tiydwe/SRAM/README.md

# SRAM from scratch
256 bytes of SRAM from discrete sot-23 mosfets built without any ICs!

I'm still working on this project!

More coming to this README eventually.
