tiydwe/SRAM/BOM.xlsx

Item | Qty | Cost (total) | Description | URL
OSEN 2300 | 3000 | $16.80 | n-mosfets | https://www.lcsc.com/product-detail/C20607736.html
OSEN 2301 | 3000 | $21.00 | p-mosfets | https://www.lcsc.com/product-detail/C20607737.html
Lian Xin Technology XDFH-0259-2*20P | 25 | $15.32 | idc headers, right angle | https://www.lcsc.com/product-detail/C19193829.html
Lian Xin Technology XDFH-0254-2*20P | 20 | $8.72 | idc headers | https://www.lcsc.com/product-detail/C19193815.html
YFW MUR1560FAC | 15 | $6.35 | diodes for charge pump | https://www.lcsc.com/product-detail/C3039987.html
luJing 1N4148 | 50 | $0.43 | diodes for rising edge detector | https://www.lcsc.com/product-detail/C49318123.html
YAGEO CC0805KRX7R9BB104 | 600 | $7.68 | general decoupling caps 0805 (100n) | https://www.lcsc.com/product-detail/C49678.html
YAGEO CC0603KRX7R0BB104 | 500 | $4.40 | general decoupling caps 0603 (100n) | https://www.lcsc.com/product-detail/C113803.html
HRE CGA0805X5R475K500MT | 20 | $0.78 | more capacitors (4.7u) | https://www.lcsc.com/product-detail/C6119903.html
HRE CGA1206X5R476M250NT | 10 | $2.88 | more capacitors (47u) | https://www.lcsc.com/product-detail/C6119973.html
ChuangHui RV102M250G120R1Z00ZZ | 10 | $2.53 | capacitors for charge pump (1m, low esr) | https://www.lcsc.com/product-detail/C49435126.html
FH RS-06000JT | 100 | $0.35 | resistors (0) | https://www.lcsc.com/product-detail/C115323.html
FOJAN FRC0805F1R00TS | 100 | $0.42 | resistors (1) | https://www.lcsc.com/product-detail/C2907233.html
FOJAN FRC0805F4R70TS | 100 | $0.41 | resistors (4.7) | https://www.lcsc.com/product-detail/C2933459.html
FOJAN FRC0805F10R0TS | 100 | $0.32 | resistors (10) | https://www.lcsc.com/product-detail/C2907220.html
FOJAN FRC0805F47R0TS | 100 | $0.32 | resistors (47) | https://www.lcsc.com/product-detail/C2907268.html
FOJAN FRC0805F4700TS | 100 | $0.32 | resistors (470) | https://www.lcsc.com/product-detail/C2907267.html
FOJAN FRC0805F4701TS | 100 | $0.30 | resistors (4.7k) | https://www.lcsc.com/product-detail/C2907264.html
FOJAN FRC0805F1002TS | 100 | $0.27 | resistors (10k) | https://www.lcsc.com/product-detail/C2907219.html
FOJAN FRC0805F4702TS | 100 | $0.32 | resistors (47k) | https://www.lcsc.com/product-detail/C2930202.html
FOJAN FRC0805F1003TS | 100 | $0.33 | resistors (100k) | https://www.lcsc.com/product-detail/C2907217.html
PCB (ram controller board) | 1 | $50.00 | approx value, not quoted yet | N/A
PCB (main demux board) | 1 | $48.37 | 150mmx150mm, 4 layer, tg155, lead free hasl | N/A
PCBA (main boards) | 17 | $380.00 | including the 20 thousand mosfets | N/A
KNSCHA 126RV0112 | 100 | $4.40 | some more capacitors (100u) | https://www.lcsc.com/product-detail/C7461243.html
Yongyu PhotXINGLIGHT XL-2012SURC-FJoelectric SZYY0805R | 500 | $8.80 | red leds | https://www.lcsc.com/product-detail/C7371909.html
FOJAN FRC0805F1800TS | 500 | $1.15 | resistors (180) for led circuit | https://www.lcsc.com/product-detail/C2933344.html
hanxia HX PZ1.0-1x2P ZZ | 150 | $4.86 | pin headers, small | https://www.lcsc.com/product-detail/C22438170.html
RS-03K47R0FT | 2186 | $0.00 | included in pcb price, 47 ohm resistors | https://www.lcsc.com/product-detail/C140087.html
FOJAN FRC0603F1002TS | 282 | $0.00 | included in pcb price, 10k ohm resistors | https://www.lcsc.com/product-detail/C2906982.html
SHOU HAN TS4538TP 250gf 009 | 150 | $2.61 | push buttons | https://www.lcsc.com/product-detail/C5359325.html
PCB (input board) | 1 | $15.00 | pcb | N/A
JLCPCB shipping + tarrifs | N/A | $100.00 | approx, based on past experience and extrapolating | N/A
LCSC shipping + tarriffs | N/A | $50.00 | approx, based on past experience and extrapolating | N/A
GRAND TOTAL |  | $755.44
