tiydwe/SRAM/kicad/inputBoard/production/bom.csv

Designator | Footprint | Quantity | Value | LCSC Part #
J1_4, J1_3, J1_2, J1, J2_4, J2_3, J2_2, J2, J3_4, J3_3, J3_2, J3, J4_4, J4_3, J4_2, J4, J5_4, J5_3, J5_2, J5, J6_4, J6_3, J6_2, J6, J7_4, J7_3, J7_2, J7, J8_4, J8_3, J8_2, J8 | PinHeader_1x02_P1.00mm_Vertical | 32 | Conn_01x02_Pin
R1_4, R1_3, R1_2, R1, R2_4, R2_3, R2_2, R2, R3_4, R3_3, R3_2, R3, R4_4, R4_3, R4_2, R4, R5_4, R5_3, R5_2, R5 | 1206 | 20 | 0R
SW1_4, SW1_3, SW1_2, SW1, SW10_4, SW10_3, SW10_2, SW10, SW11_4, SW11_3, SW11_2, SW11, SW12_4, SW12_3, SW12_2, SW12, SW13_4, SW13_3, SW13_2, SW13, SW14_4, SW14_3, SW14_2, SW14, SW15_4, SW15_3, SW15_2, SW15, SW16_4, SW16_3, SW16_2, SW16, SW2_4, SW2_3, SW2_2, SW2, SW3_4, SW3_3, SW3_2, SW3, SW4_4, SW4_3, SW4_2, SW4, SW5_4, SW5_3, SW5_2, SW5, SW6_4, SW6_3, SW6_2, SW6, SW7_4, SW7_3, SW7_2, SW7, SW8_4, SW8_3, SW8_2, SW8, SW9_4, SW9_3, SW9_2, SW9 | SW_4.5mm | 64 | SW_Push
