tiydwe/SRAM/kicad/smt_to_dip/production/bom.csv

Designator | Footprint | Quantity | Value | LCSC Part #
J1_91, J1_90, J1_89, J1_88, J1_87, J1_86, J1_85, J1_84, J1_83, J1_82, J1_81, J1_80, J1_79, J1_78, J1_77, J1_76, J1_75, J1_74, J1_73, J1_72, J1_71, J1_70, J1_69, J1_68, J1_67, J1_66, J1_65, J1_64, J1_63, J1_62, J1_61, J1_60, J1_59, J1_58, J1_57, J1_56, J1_55, J1_54, J1_53, J1_52, J1_51, J1_50, J1_49, J1_48, J1_47, J1_46, J1_45, J1_44, J1_43, J1_42, J1_41, J1_40, J1_39, J1_38, J1_37, J1_36, J1_35, J1_34, J1_33, J1_32, J1_31, J1_30, J1_29, J1_28, J1_27, J1_26, J1_25, J1_24, J1_23, J1_22, J1_21, J1_20, J1_19, J1_18, J1_17, J1_16, J1_15, J1_14, J1_13, J1_12, J1_11, J1_10, J1_9, J1_8, J1_7, J1_6, J1_5, J1_4, J1_3, J1_2, J1 | PinHeader_1x03_P2.54mm_Vertical | 91 | Conn_01x03_Pin
Q1_91, Q1_90, Q1_89, Q1_88, Q1_87, Q1_86, Q1_85, Q1_84, Q1_83, Q1_82, Q1_81, Q1_80, Q1_79, Q1_78, Q1_77, Q1_76, Q1_75, Q1_74, Q1_73, Q1_72, Q1_71, Q1_70, Q1_69, Q1_68, Q1_67, Q1_66, Q1_65, Q1_64, Q1_63, Q1_62, Q1_61, Q1_60, Q1_59, Q1_58, Q1_57, Q1_56, Q1_55, Q1_54, Q1_53, Q1_52, Q1_51, Q1_50, Q1_49, Q1_48, Q1_47, Q1_46, Q1_45, Q1_44, Q1_43, Q1_42, Q1_41, Q1_40, Q1_39, Q1_38, Q1_37, Q1_36, Q1_35, Q1_34, Q1_33, Q1_32, Q1_31, Q1_30, Q1_29, Q1_28, Q1_27, Q1_26, Q1_25, Q1_24, Q1_23, Q1_22, Q1_21, Q1_20, Q1_19, Q1_18, Q1_17, Q1_16, Q1_15, Q1_14, Q1_13, Q1_12, Q1_11, Q1_10, Q1_9, Q1_8, Q1_7, Q1_6, Q1_5, Q1_4, Q1_3, Q1_2, Q1 | SOT-23 | 91 | Q_NMOS_GSD
R1_91, R1_90, R1_89, R1_88, R1_87, R1_86, R1_85, R1_84, R1_83, R1_82, R1_81, R1_80, R1_79, R1_78, R1_77, R1_76, R1_75, R1_74, R1_73, R1_72, R1_71, R1_70, R1_69, R1_68, R1_67, R1_66, R1_65, R1_64, R1_63, R1_62, R1_61, R1_60, R1_59, R1_58, R1_57, R1_56, R1_55, R1_54, R1_53, R1_52, R1_51, R1_50, R1_49, R1_48, R1_47, R1_46, R1_45, R1_44, R1_43, R1_42, R1_41, R1_40, R1_39, R1_38, R1_37, R1_36, R1_35, R1_34, R1_33, R1_32, R1_31, R1_30, R1_29, R1_28, R1_27, R1_26, R1_25, R1_24, R1_23, R1_22, R1_21, R1_20, R1_19, R1_18, R1_17, R1_16, R1_15, R1_14, R1_13, R1_12, R1_11, R1_10, R1_9, R1_8, R1_7, R1_6, R1_5, R1_4, R1_3, R1_2, R1 | 0603 | 91 | R
R2_91, R2_90, R2_89, R2_88, R2_87, R2_86, R2_85, R2_84, R2_83, R2_82, R2_81, R2_80, R2_79, R2_78, R2_77, R2_76, R2_75, R2_74, R2_73, R2_72, R2_71, R2_70, R2_69, R2_68, R2_67, R2_66, R2_65, R2_64, R2_63, R2_62, R2_61, R2_60, R2_59, R2_58, R2_57, R2_56, R2_55, R2_54, R2_53, R2_52, R2_51, R2_50, R2_49, R2_48, R2_47, R2_46, R2_45, R2_44, R2_43, R2_42, R2_41, R2_40, R2_39, R2_38, R2_37, R2_36, R2_35, R2_34, R2_33, R2_32, R2_31, R2_30, R2_29, R2_28, R2_27, R2_26, R2_25, R2_24, R2_23, R2_22, R2_21, R2_20, R2_19, R2_18, R2_17, R2_16, R2_15, R2_14, R2_13, R2_12, R2_11, R2_10, R2_9, R2_8, R2_7, R2_6, R2_5, R2_4, R2_3, R2_2, R2 | 0805 | 91 | R
R3_91, R3_90, R3_89, R3_88, R3_87, R3_86, R3_85, R3_84, R3_83, R3_82, R3_81, R3_80, R3_79, R3_78, R3_77, R3_76, R3_75, R3_74, R3_73, R3_72, R3_71, R3_70, R3_69, R3_68, R3_67, R3_66, R3_65, R3_64, R3_63, R3_62, R3_61, R3_60, R3_59, R3_58, R3_57, R3_56, R3_55, R3_54, R3_53, R3_52, R3_51, R3_50, R3_49, R3_48, R3_47, R3_46, R3_45, R3_44, R3_43, R3_42, R3_41, R3_40, R3_39, R3_38, R3_37, R3_36, R3_35, R3_34, R3_33, R3_32, R3_31, R3_30, R3_29, R3_28, R3_27, R3_26, R3_25, R3_24, R3_23, R3_22, R3_21, R3_20, R3_19, R3_18, R3_17, R3_16, R3_15, R3_14, R3_13, R3_12, R3_11, R3_10, R3_9, R3_8, R3_7, R3_6, R3_5, R3_4, R3_3, R3_2, R3 | 1206 | 91 | R
