tiydwe/SRAM/kicad/mainDemuxBoard/production/bom.csv

Designator | Footprint | Quantity | Value | LCSC Part #
J1, J10, J11, J12, J13, J14, J15, J16, J17, J2, J3, J4, J5, J6, J7, J8, J9 | IDC-Header_2x20_P2.54mm_Latch_Vertical | 17 | Conn_02x20_Top_Bottom
Q1, Q10, Q100, Q101, Q102, Q103, Q109, Q11, Q110, Q111, Q112, Q113, Q119, Q12, Q120, Q121, Q122, Q123, Q129, Q13, Q130, Q131, Q132, Q133, Q139, Q140, Q141, Q142, Q143, Q149, Q150, Q151, Q152, Q153, Q159, Q160, Q161, Q162, Q163, Q19, Q20, Q21, Q22, Q23, Q29, Q3, Q30, Q31, Q32, Q33, Q39, Q40, Q41, Q42, Q43, Q49, Q5, Q50, Q51, Q52, Q53, Q59, Q60, Q61, Q62, Q63, Q69, Q7, Q70, Q71, Q72, Q73, Q79, Q80, Q81, Q82, Q83, Q89, Q9, Q90, Q91, Q92, Q93, Q99 | SOT-23-P | 84 | PMOS | C41384537
Q104, Q105, Q106, Q107, Q108, Q114, Q115, Q116, Q117, Q118, Q124, Q125, Q126, Q127, Q128, Q134, Q135, Q136, Q137, Q138, Q14, Q144, Q145, Q146, Q147, Q148, Q15, Q154, Q155, Q156, Q157, Q158, Q16, Q164, Q165, Q166, Q167, Q168, Q169, Q17, Q170, Q171, Q172, Q173, Q174, Q175, Q176, Q177, Q178, Q179, Q18, Q180, Q181, Q182, Q183, Q184, Q2, Q24, Q25, Q26, Q27, Q28, Q34, Q35, Q36, Q37, Q38, Q4, Q44, Q45, Q46, Q47, Q48, Q54, Q55, Q56, Q57, Q58, Q6, Q64, Q65, Q66, Q67, Q68, Q74, Q75, Q76, Q77, Q78, Q8, Q84, Q85, Q86, Q87, Q88, Q94, Q95, Q96, Q97, Q98 | SOT-23-N | 100 | NMOS | C49308282
R1, R10, R11, R12, R13, R14, R15, R16, R2, R3, R4, R5, R6, R7, R8, R9 | 0603 | 16 | 10kR | C54920960
