tiydwe/SRAM/kicad/sramBoard/sramBoard.csv

Reference | Qty | Value | DNP | Exclude from BOM | Exclude from Board | Exclude from Simulation | Exclude from Position Files | Footprint | Datasheet
Q1,Q2,Q4,Q6,Q7,Q8,Q9,Q10,Q12,Q14,Q15,Q16,Q17,Q18,Q20,Q22,Q23,Q24,Q25,Q26,Q28,Q30,Q31,Q32,Q33,Q34,Q36,Q38,Q39,Q40,Q41,Q42,Q44,Q46,Q47,Q48,Q49,Q50,Q52,Q54,Q55,Q56,Q57,Q58,Q60,Q62,Q63,Q64,Q65,Q66,Q68,Q70,Q71,Q72,Q73,Q74,Q76,Q78,Q79,Q80,Q81,Q82,Q84,Q86,Q87,Q88,Q89,Q90,Q92,Q94,Q95,Q96,Q97,Q98,Q100,Q102,Q103,Q104,Q105,Q106,Q108,Q110,Q111,Q112,Q113,Q114,Q116,Q118,Q119,Q120,Q121,Q122,Q124,Q126,Q127,Q128,Q129,Q130,Q132,Q134,Q135,Q136,Q137,Q138,Q140,Q142,Q143,Q144,Q145,Q146,Q148,Q150,Q151,Q152,Q153,Q154,Q156,Q158,Q159,Q160,Q161,Q162,Q164,Q166,Q167,Q168,Q169,Q170,Q172,Q174,Q175,Q176,Q177,Q178,Q180,Q182,Q183,Q184,Q185,Q186,Q188,Q190,Q191,Q192,Q193,Q194,Q196,Q198,Q199,Q200,Q201,Q202,Q204,Q206,Q207,Q208,Q209,Q210,Q212,Q214,Q215,Q216,Q217,Q218,Q220,Q222,Q223,Q224,Q225,Q226,Q228,Q230,Q231,Q232,Q233,Q234,Q236,Q238,Q239,Q240,Q241,Q242,Q244,Q246,Q247,Q248,Q249,Q250,Q252,Q254,Q255,Q256,Q257,Q258,Q260,Q262,Q263,Q264,Q265,Q266,Q268,Q270,Q271,Q272,Q273,Q274,Q276,Q278,Q279,Q280,Q281,Q282,Q284,Q286,Q287,Q288,Q289,Q290,Q292,Q294,Q295,Q296,Q297,Q298,Q300,Q302,Q303,Q304,Q305,Q306,Q308,Q310,Q311,Q312,Q313,Q314,Q316,Q318,Q319,Q320,Q321,Q322,Q324,Q326,Q327,Q328,Q329,Q330,Q332,Q334,Q335,Q336,Q337,Q338,Q340,Q342,Q343,Q344,Q345,Q346,Q348,Q350,Q351,Q352,Q353,Q354,Q356,Q358,Q359,Q360,Q361,Q362,Q364,Q366,Q367,Q368,Q369,Q370,Q372,Q374,Q375,Q376,Q377,Q378,Q380,Q382,Q383,Q384,Q385,Q386,Q388,Q390,Q391,Q392,Q393,Q394,Q396,Q398,Q399,Q400,Q401,Q402,Q404,Q406,Q407,Q408,Q409,Q410,Q412,Q414,Q415,Q416,Q417,Q418,Q420,Q422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 | 868 | NMOS |  |  |  |  | ${EXCLUDE_FROM_POS_FILES} | easyeda2kicad:SOT-23-N | https://ngspice.sourceforge.io/docs/ngspice-html-manual/manual.xhtml#cha_MOSFETs
Q3,Q5,Q11,Q13,Q19,Q21,Q27,Q29,Q35,Q37,Q43,Q45,Q51,Q53,Q59,Q61,Q67,Q69,Q75,Q77,Q83,Q85,Q91,Q93,Q99,Q101,Q107,Q109,Q115,Q117,Q123,Q125,Q131,Q133,Q139,Q141,Q147,Q149,Q155,Q157,Q163,Q165,Q171,Q173,Q179,Q181,Q187,Q189,Q195,Q197,Q203,Q205,Q211,Q213,Q219,Q221,Q227,Q229,Q235,Q237,Q243,Q245,Q251,Q253,Q259,Q261,Q267,Q269,Q275,Q277,Q283,Q285,Q291,Q293,Q299,Q301,Q307,Q309,Q315,Q317,Q323,Q325,Q331,Q333,Q339,Q341,Q347,Q349,Q355,Q357,Q363,Q365,Q371,Q373,Q379,Q381,Q387,Q389,Q395,Q397,Q403,Q405,Q411,Q413,Q419,Q421,Q427,Q429,Q435,Q437,Q443,Q445,Q451,Q453,Q459,Q461,Q467,Q469,Q475,Q477,Q483,Q485,Q491,Q493,Q499,Q501,Q507,Q509,Q515,Q517,Q523,Q525,Q531,Q533,Q539,Q541,Q547,Q549,Q555,Q557,Q563,Q565,Q571,Q573,Q579,Q581,Q587,Q589,Q595,Q597,Q603,Q605,Q611,Q613,Q619,Q621,Q627,Q629,Q635,Q637,Q643,Q645,Q651,Q653,Q659,Q661,Q667,Q669,Q675,Q677,Q683,Q685,Q691,Q693,Q699,Q701,Q707,Q709,Q715,Q717,Q723,Q725,Q731,Q733,Q739,Q741,Q747,Q749,Q755,Q757,Q763,Q765,Q771,Q773,Q779,Q781,Q787,Q789,Q795,Q797,Q803,Q805,Q811,Q813,Q819,Q821,Q827,Q829,Q835,Q837,Q843,Q845,Q851,Q853,Q859,Q861,Q867,Q869,Q875,Q877,Q883,Q885,Q891,Q893,Q899,Q901,Q907,Q909,Q915,Q917,Q923,Q925,Q931,Q933,Q939,Q941,Q947,Q949,Q955,Q957,Q963,Q965,Q971,Q973,Q979,Q981,Q987,Q989,Q995,Q997,Q1003,Q1005,Q1011,Q1013,Q1019,Q1021,Q1025,Q1027,Q1029,Q1031,Q1033,Q1034,Q1035,Q1036,Q1037,Q1043,Q1044,Q1045,Q1046,Q1047,Q1053,Q1054,Q1055,Q1056,Q1057,Q1063,Q1064,Q1065,Q1066,Q1067,Q1073,Q1074,Q1075,Q1076,Q1077,Q1083,Q1084,Q1085,Q1086,Q1087,Q1093,Q1094,Q1095,Q1096,Q1097,Q1103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 | 340 | PMOS |  |  |  |  | ${EXCLUDE_FROM_POS_FILES} | easyeda2kicad:SOT-23-P | https://ngspice.sourceforge.io/docs/ngspice-html-manual/manual.xhtml#cha_MOSFETs
R1,R2,R3,R4,R5,R6,R7,R8,R9,R10,R11,R12,R13,R14,R15,R16,R17,R18,R19,R20,R21,R22,R23,R24,R25,R26,R27,R28,R29,R30,R31,R32,R33,R34,R35,R36,R37,R38,R39,R40,R41,R42,R43,R44,R45,R46,R47,R48,R49,R50,R51,R52,R53,R54,R55,R56,R57,R58,R59,R60,R61,R62,R63,R64,R65,R66,R67,R68,R69,R70,R71,R72,R73,R74,R75,R76,R77,R78,R79,R80,R81,R82,R83,R84,R85,R86,R87,R88,R89,R90,R91,R92,R93,R94,R95,R96,R97,R98,R99,R100,R101,R102,R103,R104,R105,R106,R107,R108,R109,R110,R111,R112,R113,R114,R115,R116,R117,R118,R119,R120,R121,R122,R123,R124,R125,R126,R127,R128 | 128 | 47R |  |  |  |  | ${EXCLUDE_FROM_POS_FILES} | Resistor_SMD:R_0603_1608Metric
R129,R130,R131,R132,R133,R134,R135,R136,R137,R138,R139,R140,R141,R142,R143,R144 | 16 | 10kR |  |  |  |  | ${EXCLUDE_FROM_POS_FILES} | Resistor_SMD:R_0603_1608Metric
