tiydwe/SRAM/ltspice/powermanagement.asc

C3: cap; 100nC
C4: cap; 1mC
C5: cap; 1mC
C6: cap; 1mC
C7: cap; 1mC
C8: cap; 1mC
D1: diode
D2: diode
D3: diode
D4: diode
D5: diode
D6: diode
D7: diode
D8: diode
D9: diode
D10: diode
D11: diode
D12: diode
M3: pmos; DO2301E-Q
M4: nmos; JTD2302B
M5: pmos; DO2301E-Q
M6: nmos; JTD2302B
M7: pmos; DO2301E-Q
M8: nmos; JTD2302B
M10: pmos; DO2301E-Q
M11: pmos; DO2301E-Q
M12: pmos; DO2301E-Q
M13: nmos; JTD2302B
M15: nmos; JTD2302B
M17: nmos; JTD2302B
R5: res; 470R
R6: res; 10R
R9: res; 47R
R10: res; 47R
R11: res; 1R
R12: res; 47R
R13: res; 47R
R14: res; 1R
V1: voltage; 5
Named nets: 0
.model JTD2302B NMOS(Level=1 Vto=0.65 Kp=22.8 Lambda=0.01 Rs=15m Rd=20m Cgso=120p Cgdo=80p Cbd=120p Vact=20 Is=1n)
.model DO2301E-Q PMOS(Level=1 Vto=-0.6 Kp=6.75 Lambda=0.02 Rd=40m Rs=17m Rg=5 Rds=20Meg Cgso=126p Cgdo=30p Cbd=10p Pb=0.8 Mj=0.5 Is=1e-14 N=1 Rb=0.1 mfg=Doingter)
.tran 0 50m 0 startup
