tiydwe/SRAM/ltspice/mainSimulation.asc

M1: pmos; DO2301E-Q
M2: pmos; DO2301E-Q
M3: nmos; JTD2302B
M4: nmos; JTD2302B
M5: pmos; DO2301E-Q
M6: pmos; DO2301E-Q
M7: nmos; JTD2302B
M8: nmos; JTD2302B
M27: pmos; DO2301E-Q
M28: nmos; JTD2302B
V1: voltage; 5
V2: voltage; PWL(0m 0 400m 0 401m 5)
V3: voltage; PULSE(0 5 100m 1m 1m 50m 100m)
Named nets: 0
.model JTD2302B NMOS(Level=1 Vto=0.65 Kp=22.8 Lambda=0.01 Rs=15m Rd=20m Cgso=120p Cgdo=80p Cbd=120p Vact=20 Is=1n)
.model DO2301E-Q PMOS(Level=1 Vto=-0.6 Kp=6.75 Lambda=0.02 Rd=40m Rs=17m Rg=5 Rds=20Meg Cgso=126p Cgdo=30p Cbd=10p Pb=0.8 Mj=0.5 Is=1e-14 N=1 Rb=0.1 mfg=Doingter)
.tran 0 1 0 startup
.options cshunt=1e-12
