tiydwe/SRAM/ltspice/simulation.asc

C1: cap; 100pC
C3: cap; 32n
M1: nmos; JTD2302B
M2: nmos; JTD2302B
M3: nmos; JTD2302B
M4: nmos; JTD2302B
M5: nmos; JTD2302B
M6: nmos; JTD2302B
M7: pmos; DO2301E-Q
M8: pmos; DO2301E-Q
M9: nmos; JTD2302B
M10: nmos; JTD2302B
M11: nmos; JTD2302B
M12: pmos; DO2301E-Q
M13: pmos; DO2301E-Q
M14: nmos; JTD2302B
M15: pmos; DO2301E-Q
M16: pmos; DO2301E-Q
M17: nmos; JTD2302B
M18: nmos; JTD2302B
M19: nmos; JTD2302B
M20: nmos; JTD2302B
M21: nmos; JTD2302B
M22: nmos; JTD2302B
M23: nmos; JTD2302B
M24: nmos; JTD2302B
M25: nmos; JTD2302B
M26: nmos; JTD2302B
M27: nmos; JTD2302B
M28: nmos; JTD2302B
M29: nmos; JTD2302B
M30: nmos; JTD2302B
M31: nmos; JTD2302B
M32: nmos; JTD2302B
M33: nmos; JTD2302B
M34: nmos; JTD2302B
M35: nmos; JTD2302B
M36: nmos; JTD2302B
M37: pmos; DO2301E-Q
M38: pmos; DO2301E-Q
M39: nmos; JTD2302B
M40: nmos; JTD2302B
M41: pmos; DO2301E-Q
M42: nmos; JTD2302B
M43: nmos; JTD2302B
M44: pmos; DO2301E-Q
M45: nmos; JTD2302B
M46: pmos; DO2301E-Q
R1: res; 10kR
R2: res; 1R
R3: res; 47R
R4: res; 1R
R5: res; 10kR
R6: res; 10kR
R7: res; 10kR
R8: res; 10kR
V1: voltage; 5
V2: voltage; PWL(0 0 95m 0 100m 5)
V3: voltage; PWL(0 5 200m 5 205m 0)
V4: voltage; 5
V5: voltage; PWL(0 5 200m 5 205m 0 295m 0 300m 5)
V7: voltage; PWL(0 0 49m 0 50m 10 99m 10 100m 0 149m 0 150m 10 199m 10 200m 0 249m 0 250m 10 299m 10 300m 0)
Named nets: 0
.model JTD2302B NMOS(Level=1 Vto=0.65 Kp=22.8 Lambda=0.01 Rs=15m Rd=20m Cgso=120p Cgdo=80p Cbd=120p Vact=20 Is=1n)
.model DO2301E-Q PMOS(Level=1 Vto=-0.6 Kp=6.75 Lambda=0.02 Rd=40m Rs=17m Rg=5 Rds=20Meg Cgso=126p Cgdo=30p Cbd=10p Pb=0.8 Mj=0.5 Is=1e-14 N=1 Rb=0.1 mfg=Doingter)
.tran 0 1 0 startup
