tiydwe/SRAM/ltspice/schmitt_trigger.asc

C1: cap; 1pC
C2: cap; 4.7µC
C3: cap; 100nC
C5: cap; 100nC
C6: cap; 4.7µC
C7: cap; 100nC
C8: cap; 100nC
C9: cap; 100nC
C10: cap; 4.7µC
C11: cap; 1µC
D1: diode
D2: diode
D3: diode
M1: pmos; DO2301E-Q
M2: pmos; DO2301E-Q
M3: pmos; DO2301E-Q
M4: nmos; JTD2302B
M5: pmos; DO2301E-Q
M6: nmos; JTD2302B
M7: nmos; JTD2302B
M8: nmos; JTD2302B
M9: pmos; DO2301E-Q
M10: nmos; JTD2302B
M11: pmos; DO2301E-Q
M12: nmos; JTD2302B
M13: pmos; DO2301E-Q
M14: nmos; JTD2302B
M15: pmos; DO2301E-Q
M16: nmos; JTD2302B
M17: pmos; DO2301E-Q
M18: nmos; JTD2302B
M19: pmos; DO2301E-Q
M20: nmos; JTD2302B
M21: pmos; DO2301E-Q
M22: nmos; JTD2302B
M23: pmos; DO2301E-Q
M24: nmos; JTD2302B
M25: pmos; DO2301E-Q
M26: nmos; JTD2302B
M27: pmos; DO2301E-Q
M28: nmos; JTD2302B
R1: res; 47R
R2: res; 47R
R3: res; 10R
R4: res; 47R
R5: res; 47R
R6: res; 10R
R7: res; 1kR
R8: res; 10kR
R9: res; 47R
R10: res; 1R
R11: res; 100kR
R12: res; 47R
R13: res; 4.7kR
R14: res; 4.7R
R15: res; 47R
R16: res; 4.7R
R17: res; 47kR
R18: res; 47R
R19: res; 4.7R
R20: res; 4.7kR
R21: res; 47R
R22: res; 4.7R
R23: res; 47R
V1: voltage; 5
V2: voltage; PWL(0m 0 100m 5 200m 5 300m 0 400m 0 450m 5 460m 3 500m 5 600m 0 700m 0 720m 3 730m 1 750m 2 780m 0)
Named nets: 0
.model JTD2302B NMOS(Level=1 Vto=0.65 Kp=22.8 Lambda=0.01 Rs=15m Rd=20m Cgso=120p Cgdo=80p Cbd=120p Vact=20 Is=1n)
.model DO2301E-Q PMOS(Level=1 Vto=-0.6 Kp=6.75 Lambda=0.02 Rd=40m Rs=17m Rg=5 Rds=20Meg Cgso=126p Cgdo=30p Cbd=10p Pb=0.8 Mj=0.5 Is=1e-14 N=1 Rb=0.1 mfg=Doingter)
.tran 0 1 0 startup
.options cshunt=1e-12
