tiydwe/SRAM/ltspice/dlatch.asc

C1: cap; 5nC
M1: pmos; DO2301E-Q
M2: pmos; DO2301E-Q
M3: nmos; JTD2302B
M4: nmos; JTD2302B
M5: pmos; DO2301E-Q
M6: pmos; DO2301E-Q
M7: nmos; JTD2302B
M8: nmos; JTD2302B
M9: nmos; JTD2302B
M10: pmos; DO2301E-Q
M11: nmos; JTD2302B
M12: pmos; DO2301E-Q
M13: nmos; JTD2302B
M15: pmos; DO2301E-Q
V1: voltage; 5
V2: voltage; PWL(0m 0 99m 0 100m 5 139m 5 140m 0 179.9m 0 180m 5 182m 5 182.1m 0)
V3: voltage; PWL(0m 0 49m 0 50m 5 79m 5 80m 0 119m 0 120m 5 159m 5 160m 0)
Named nets: 0
.model JTD2302B NMOS(Level=1 Vto=0.65 Kp=22.8 Lambda=0.01 Rs=15m Rd=20m Cgso=120p Cgdo=80p Cbd=120p Vact=20 Is=1n)
.model DO2301E-Q PMOS(Level=1 Vto=-0.6 Kp=6.75 Lambda=0.02 Rd=40m Rs=17m Rg=5 Rds=20Meg Cgso=126p Cgdo=30p Cbd=10p Pb=0.8 Mj=0.5 Is=1e-14 N=1 Rb=0.1 mfg=Doingter)
.tran 0 1 0 startup
