tiydwe/SRAM/kicad/inputBoard/inputBoard.kicad_pcb

## KiCad design kicad/inputBoard/inputBoard.kicad_pcb (2026-10-28)

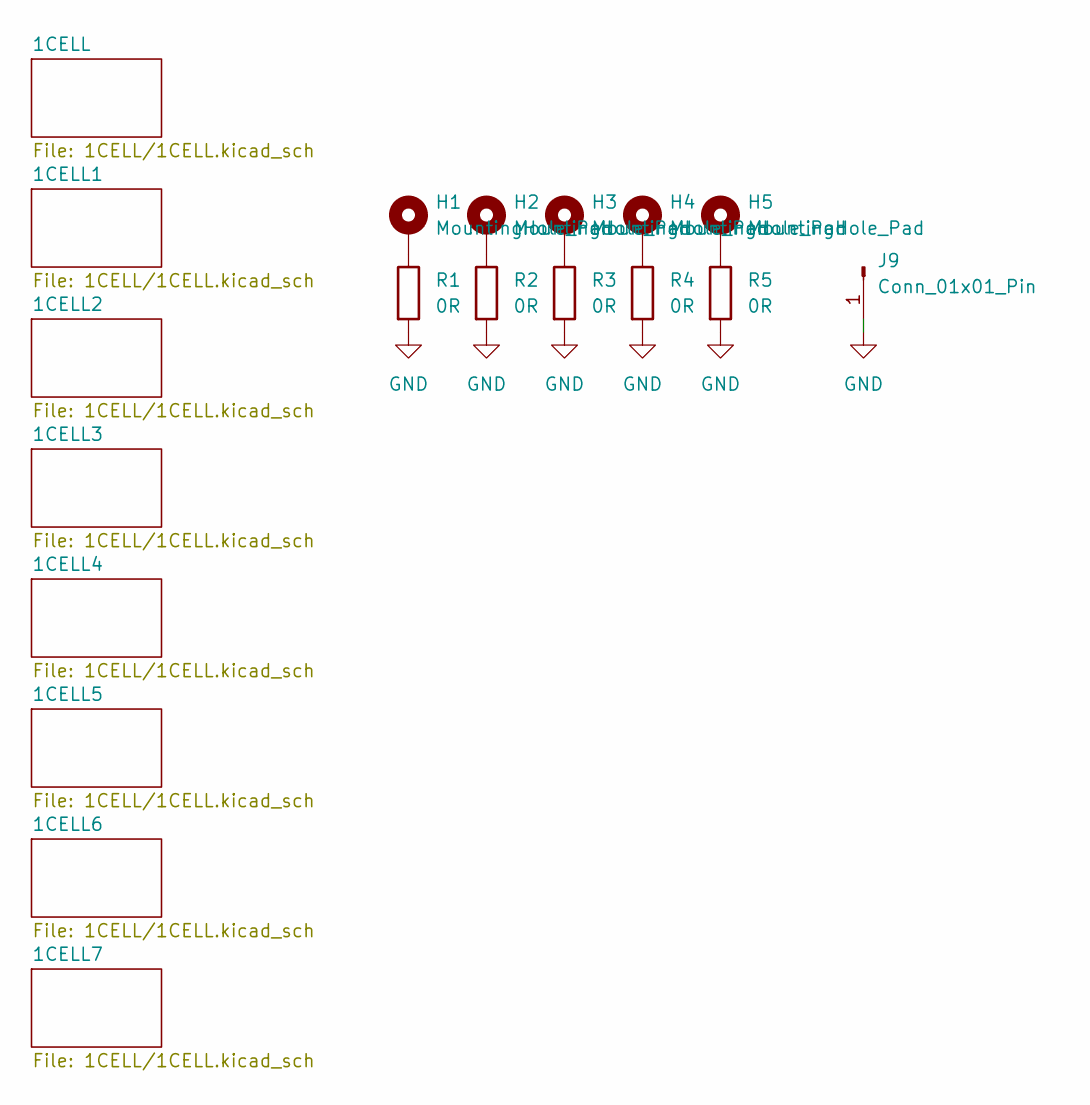
[picture p37: schematic inputBoard.kicad_sch]

Parts:
H1, H2, H3, H4, H5: MountingHole_Pad; MountingHole_2.2mm_M2_DIN965_Pad
J9: Conn_01x01_Pin; Wire_Pad_18AWG_stranded
R1, R2, R3, R4, R5: 0R; R_1206_3216Metric_Pad1.30x1.75mm_HandSolder

Connections:
GND: J9.1 (Pin_1_1), R1.2, R2.2, R3.2, R4.2, R5.2; also elsewhere on the board
unnamed: H1.1 (1_1), R1.1
unnamed: H2.1 (1_1), R2.1
unnamed: H3.1 (1_1), R3.1
unnamed: H4.1 (1_1), R4.1
unnamed: H5.1 (1_1), R5.1

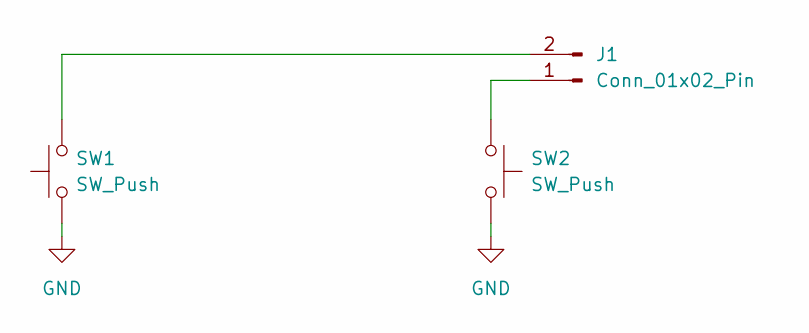
[picture p38: schematic 1CELL.kicad_sch]

Parts:
J1: Conn_01x02_Pin; PinHeader_1x02_P1.00mm_Vertical
SW1, SW2: SW_Push; SW_4.5mm

Connections:
GND: SW1.1, SW2.2; also elsewhere on the board
unnamed: J1.1, SW2.1
unnamed: J1.2, SW1.2

Parts of its further copies:
J2, J3, J4, J5, J6, J7, J8: Conn_01x02_Pin; PinHeader_1x02_P1.00mm_Vertical
SW3, SW4, SW5, SW6, SW7, SW8, SW9, SW10, SW11, SW12, SW13, SW14, SW15, SW16: SW_Push; SW_4.5mm

Connections of its further copies:
GND: SW3.1, SW4.2, SW5.1, SW6.2, SW7.1, SW8.2, SW9.1, SW10.2, SW11.1, SW12.2, SW13.1, SW14.2, SW15.1, SW16.2; also elsewhere on the board
unnamed: J2.1, SW4.1
unnamed: J2.2, SW3.2
unnamed: J3.1, SW6.1
unnamed: J3.2, SW5.2
unnamed: J4.1, SW8.1
unnamed: J4.2, SW7.2
unnamed: J5.1, SW10.1
unnamed: J5.2, SW9.2
unnamed: J6.1, SW12.1
unnamed: J6.2, SW11.2
unnamed: J7.1, SW14.1
unnamed: J7.2, SW13.2
unnamed: J8.1, SW16.1
unnamed: J8.2, SW15.2

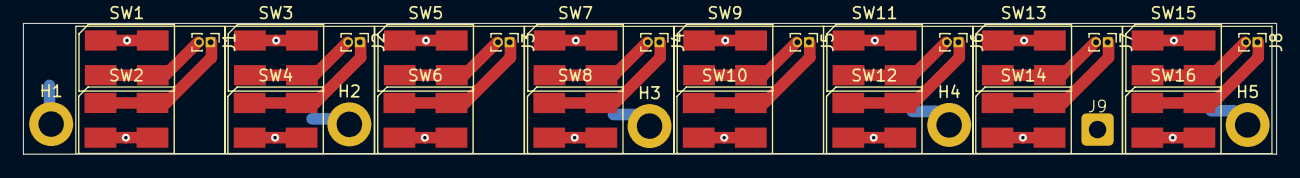
[picture p39: board inputBoard.kicad_pcb from above]

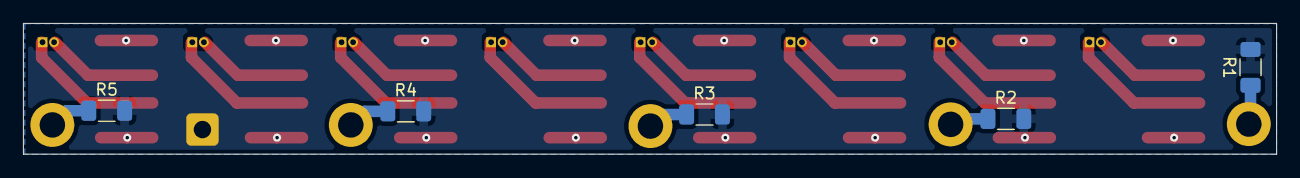
[picture p40: board inputBoard.kicad_pcb from below]

Board: 2 copper layers, 108.3 x 11.3 mm, 35 parts (5 on the bottom side), 22 nets.
