tiydwe/SRAM/kicad/mainDemuxBoard/mainDemuxBoard.kicad_pcb

## KiCad design kicad/mainDemuxBoard/mainDemuxBoard.kicad_pcb (2026-10-28)

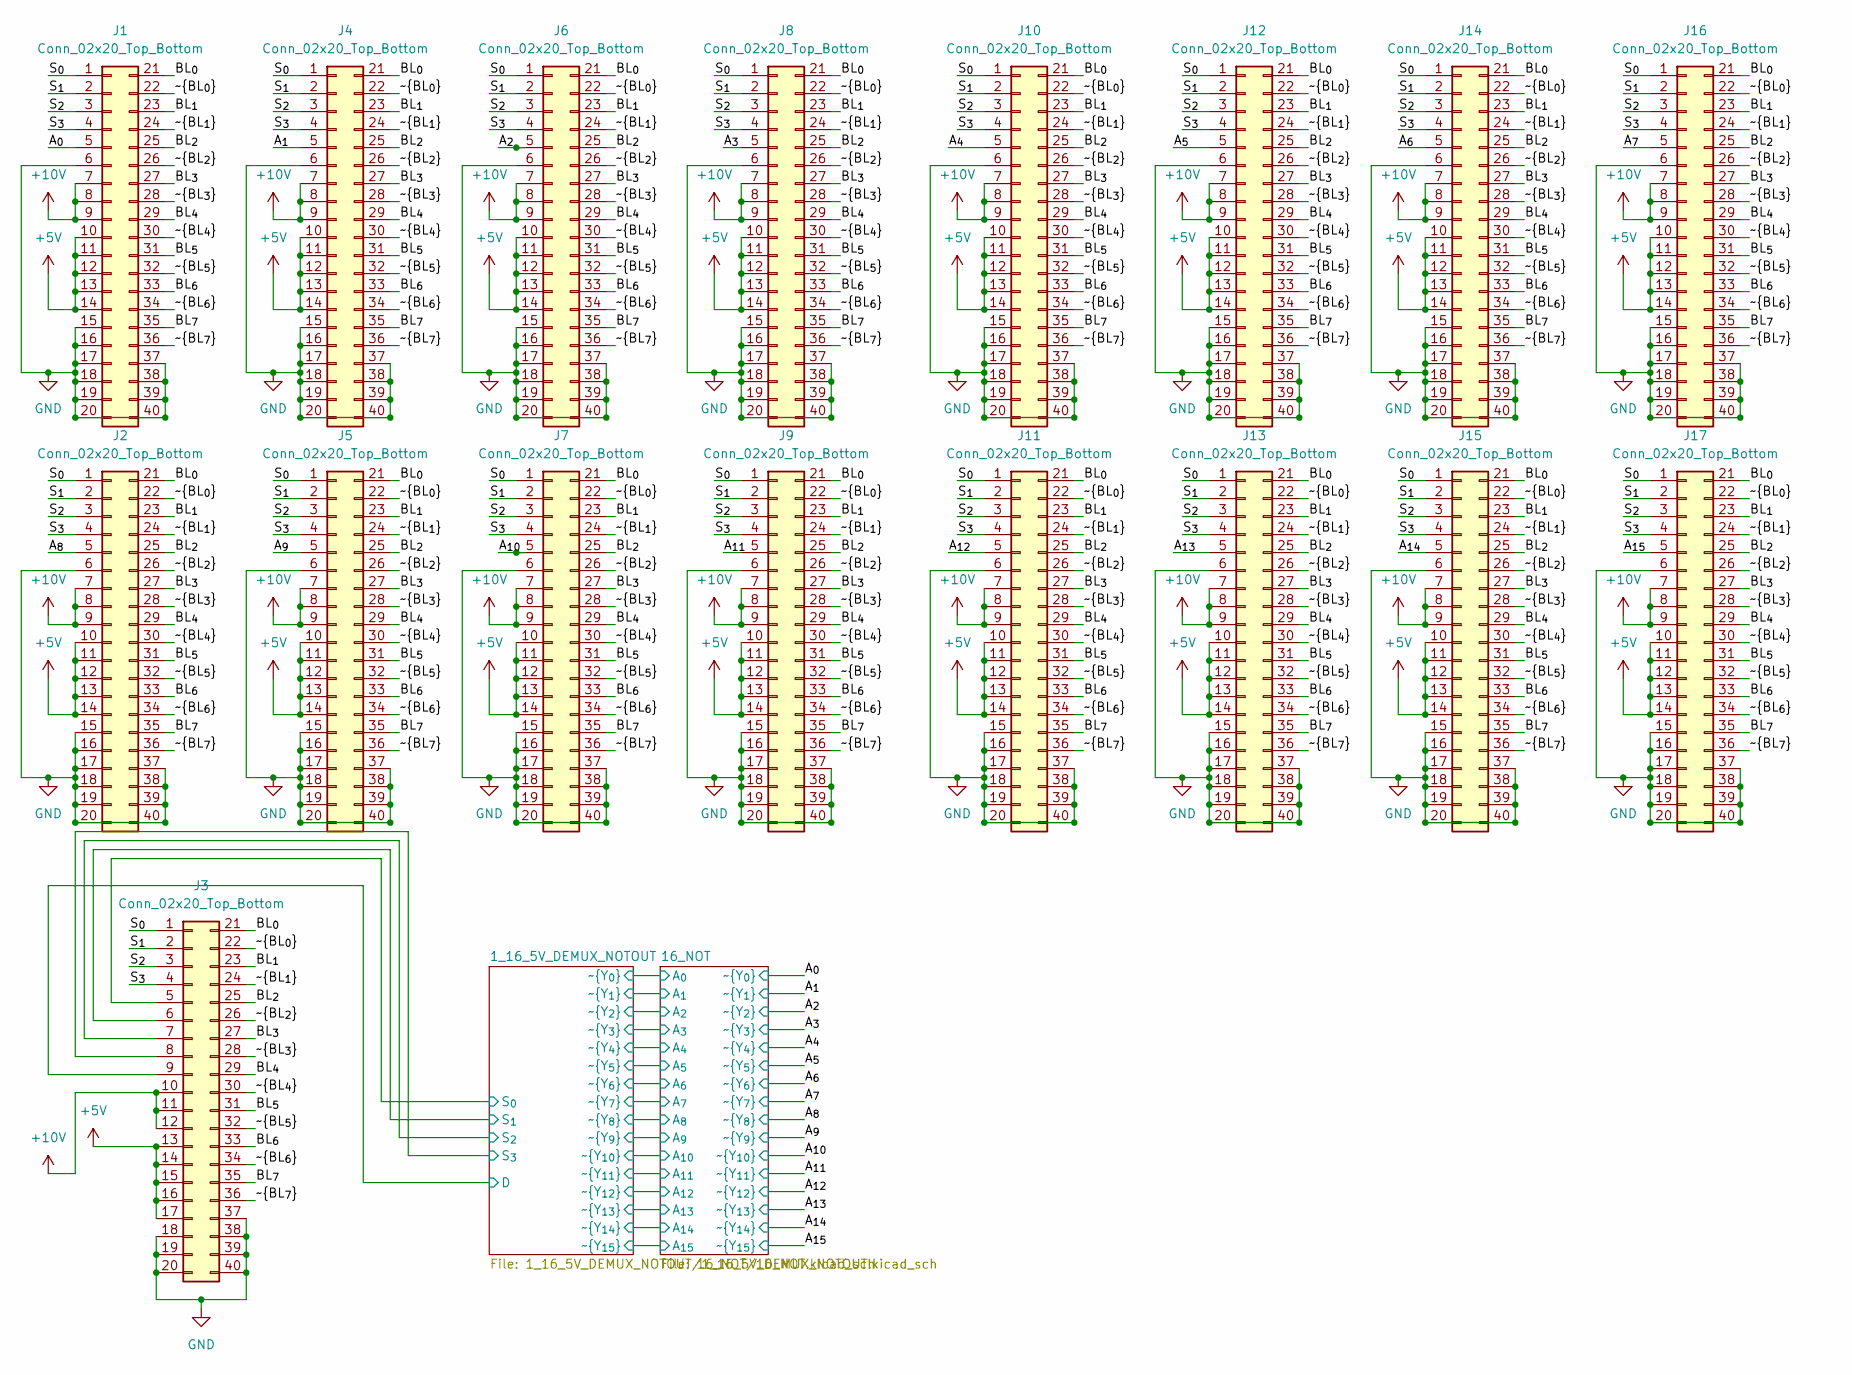
[picture p41: schematic mainDemuxBoard.kicad_sch]

Parts:
J1, J2, J3, J4, J5, J6, J7, J8, J9, J10, J11, J12, J13, J14, J15, J16, J17: Conn_02x20_Top_Bottom; IDC-Header_2x20_P2.54mm_Latch_Vertical

Connections:
+5V: J1.10, J1.11, J1.12, J1.13, J1.14, J2.10, J2.11, J2.12, J2.13, J2.14, J3.13, J3.14, J3.15, J3.16, J3.17, J4.10, J4.11, J4.12, J4.13, J4.14, J5.10, J5.11, J5.12, J5.13, J5.14, J6.10, J6.11, J6.12, J6.13, J6.14, J7.10, J7.11, J7.12, J7.13, J7.14, J8.10, J8.11, J8.12, J8.13, J8.14, J9.10, J9.11, J9.12, J9.13, J9.14, J10.10, J10.11, J10.12, J10.13, J10.14, J11.10, J11.11, J11.12, J11.13, J11.14, J12.10, J12.11, J12.12, J12.13, J12.14, J13.10, J13.11, J13.12, J13.13, J13.14, J14.10, J14.11, J14.12, J14.13, J14.14, J15.10, J15.11, J15.12, J15.13, J15.14, J16.10, J16.11, J16.12, J16.13, J16.14, J17.10, J17.11, J17.12, J17.13, J17.14; also elsewhere on the board
+10V: J1.7, J1.8, J1.9, J2.7, J2.8, J2.9, J3.10, J3.11, J3.12, J4.7, J4.8, J4.9, J5.7, J5.8, J5.9, J6.7, J6.8, J6.9, J7.7, J7.8, J7.9, J8.7, J8.8, J8.9, J9.7, J9.8, J9.9, J10.7, J10.8, J10.9, J11.7, J11.8, J11.9, J12.7, J12.8, J12.9, J13.7, J13.8, J13.9, J14.7, J14.8, J14.9, J15.7, J15.8, J15.9, J16.7, J16.8, J16.9, J17.7, J17.8, J17.9
/1_16_5V_DEMUX_NOTOUT/D: J3.9; also elsewhere on the board
/1_16_5V_DEMUX_NOTOUT/S_{0}: J3.5; also elsewhere on the board
/1_16_5V_DEMUX_NOTOUT/S_{1}: J3.6; also elsewhere on the board
/1_16_5V_DEMUX_NOTOUT/S_{2}: J3.7; also elsewhere on the board
/1_16_5V_DEMUX_NOTOUT/S_{3}: J3.8; also elsewhere on the board
/A_{0}: J1.5; also elsewhere on the board
/A_{1}: J4.5; also elsewhere on the board
/A_{2}: J6.5; also elsewhere on the board
/A_{3}: J8.5; also elsewhere on the board
/A_{4}: J10.5; also elsewhere on the board
/A_{5}: J12.5; also elsewhere on the board
/A_{6}: J14.5; also elsewhere on the board
/A_{7}: J16.5; also elsewhere on the board
/A_{8}: J2.5; also elsewhere on the board
/A_{9}: J5.5; also elsewhere on the board
/A_{10}: J7.5; also elsewhere on the board
/A_{11}: J9.5; also elsewhere on the board
/A_{12}: J11.5; also elsewhere on the board
/A_{13}: J13.5; also elsewhere on the board
/A_{14}: J15.5; also elsewhere on the board
/A_{15}: J17.5; also elsewhere on the board
/BL_{0}: J1.21, J2.21, J3.21, J4.21, J5.21, J6.21, J7.21, J8.21, J9.21, J10.21, J11.21, J12.21, J13.21, J14.21, J15.21, J16.21, J17.21
/BL_{1}: J1.23, J2.23, J3.23, J4.23, J5.23, J6.23, J7.23, J8.23, J9.23, J10.23, J11.23, J12.23, J13.23, J14.23, J15.23, J16.23, J17.23
/BL_{2}: J1.25, J2.25, J3.25, J4.25, J5.25, J6.25, J7.25, J8.25, J9.25, J10.25, J11.25, J12.25, J13.25, J14.25, J15.25, J16.25, J17.25
/BL_{3}: J1.27, J2.27, J3.27, J4.27, J5.27, J6.27, J7.27, J8.27, J9.27, J10.27, J11.27, J12.27, J13.27, J14.27, J15.27, J16.27, J17.27
/BL_{4}: J1.29, J2.29, J3.29, J4.29, J5.29, J6.29, J7.29, J8.29, J9.29, J10.29, J11.29, J12.29, J13.29, J14.29, J15.29, J16.29, J17.29
/BL_{5}: J1.31, J2.31, J3.31, J4.31, J5.31, J6.31, J7.31, J8.31, J9.31, J10.31, J11.31, J12.31, J13.31, J14.31, J15.31, J16.31, J17.31
/BL_{6}: J1.33, J2.33, J3.33, J4.33, J5.33, J6.33, J7.33, J8.33, J9.33, J10.33, J11.33, J12.33, J13.33, J14.33, J15.33, J16.33, J17.33
/BL_{7}: J1.35, J2.35, J3.35, J4.35, J5.35, J6.35, J7.35, J8.35, J9.35, J10.35, J11.35, J12.35, J13.35, J14.35, J15.35, J16.35, J17.35
/S_{0}: J1.1, J2.1, J3.1, J4.1, J5.1, J6.1, J7.1, J8.1, J9.1, J10.1, J11.1, J12.1, J13.1, J14.1, J15.1, J16.1, J17.1
/S_{1}: J1.2, J2.2, J3.2, J4.2, J5.2, J6.2, J7.2, J8.2, J9.2, J10.2, J11.2, J12.2, J13.2, J14.2, J15.2, J16.2, J17.2
/S_{2}: J1.3, J2.3, J3.3, J4.3, J5.3, J6.3, J7.3, J8.3, J9.3, J10.3, J11.3, J12.3, J13.3, J14.3, J15.3, J16.3, J17.3
/S_{3}: J1.4, J2.4, J3.4, J4.4, J5.4, J6.4, J7.4, J8.4, J9.4, J10.4, J11.4, J12.4, J13.4, J14.4, J15.4, J16.4, J17.4
/~BL_{0}: J1.22, J2.22, J3.22, J4.22, J5.22, J6.22, J7.22, J8.22, J9.22, J10.22, J11.22, J12.22, J13.22, J14.22, J15.22, J16.22, J17.22
/~BL_{1}: J1.24, J2.24, J3.24, J4.24, J5.24, J6.24, J7.24, J8.24, J9.24, J10.24, J11.24, J12.24, J13.24, J14.24, J15.24, J16.24, J17.24
/~BL_{2}: J1.26, J2.26, J3.26, J4.26, J5.26, J6.26, J7.26, J8.26, J9.26, J10.26, J11.26, J12.26, J13.26, J14.26, J15.26, J16.26, J17.26
/~BL_{3}: J1.28, J2.28, J3.28, J4.28, J5.28, J6.28, J7.28, J8.28, J9.28, J10.28, J11.28, J12.28, J13.28, J14.28, J15.28, J16.28, J17.28
/~BL_{4}: J1.30, J2.30, J3.30, J4.30, J5.30, J6.30, J7.30, J8.30, J9.30, J10.30, J11.30, J12.30, J13.30, J14.30, J15.30, J16.30, J17.30
/~BL_{5}: J1.32, J2.32, J3.32, J4.32, J5.32, J6.32, J7.32, J8.32, J9.32, J10.32, J11.32, J12.32, J13.32, J14.32, J15.32, J16.32, J17.32
/~BL_{6}: J1.34, J2.34, J3.34, J4.34, J5.34, J6.34, J7.34, J8.34, J9.34, J10.34, J11.34, J12.34, J13.34, J14.34, J15.34, J16.34, J17.34
/~BL_{7}: J1.36, J2.36, J3.36, J4.36, J5.36, J6.36, J7.36, J8.36, J9.36, J10.36, J11.36, J12.36, J13.36, J14.36, J15.36, J16.36, J17.36
GND: J1.6, J1.15, J1.16, J1.17, J1.18, J1.19, J1.20, J1.37, J1.38, J1.39, J1.40, J2.6, J2.15, J2.16, J2.17, J2.18, J2.19, J2.20, J2.37, J2.38, J2.39, J2.40, J3.18, J3.19, J3.20, J3.37, J3.38, J3.39, J3.40, J4.6, J4.15, J4.16, J4.17, J4.18, J4.19, J4.20, J4.37, J4.38, J4.39, J4.40, J5.6, J5.15, J5.16, J5.17, J5.18, J5.19, J5.20, J5.37, J5.38, J5.39, J5.40, J6.6, J6.15, J6.16, J6.17, J6.18, J6.19, J6.20, J6.37, J6.38, J6.39, J6.40, J7.6, J7.15, J7.16, J7.17, J7.18, J7.19, J7.20, J7.37, J7.38, J7.39, J7.40, J8.6, J8.15, J8.16, J8.17, J8.18, J8.19, J8.20, J8.37, J8.38, J8.39, J8.40, J9.6, J9.15, J9.16, J9.17, J9.18, J9.19, J9.20, J9.37, J9.38, J9.39, J9.40, J10.6, J10.15, J10.16, J10.17, J10.18, J10.19, J10.20, J10.37, J10.38, J10.39, J10.40, J11.6, J11.15, J11.16, J11.17, J11.18, J11.19, J11.20, J11.37, J11.38, J11.39, J11.40, J12.6, J12.15, J12.16, J12.17, J12.18, J12.19, J12.20, J12.37, J12.38, J12.39, J12.40, J13.6, J13.15, J13.16, J13.17, J13.18, J13.19, J13.20, J13.37, J13.38, J13.39, J13.40, J14.6, J14.15, J14.16, J14.17, J14.18, J14.19, J14.20, J14.37, J14.38, J14.39, J14.40, J15.6, J15.15, J15.16, J15.17, J15.18, J15.19, J15.20, J15.37, J15.38, J15.39, J15.40, J16.6, J16.15, J16.16, J16.17, J16.18, J16.19, J16.20, J16.37, J16.38, J16.39, J16.40, J17.6, J17.15, J17.16, J17.17, J17.18, J17.19, J17.20, J17.37, J17.38, J17.39, J17.40; also elsewhere on the board

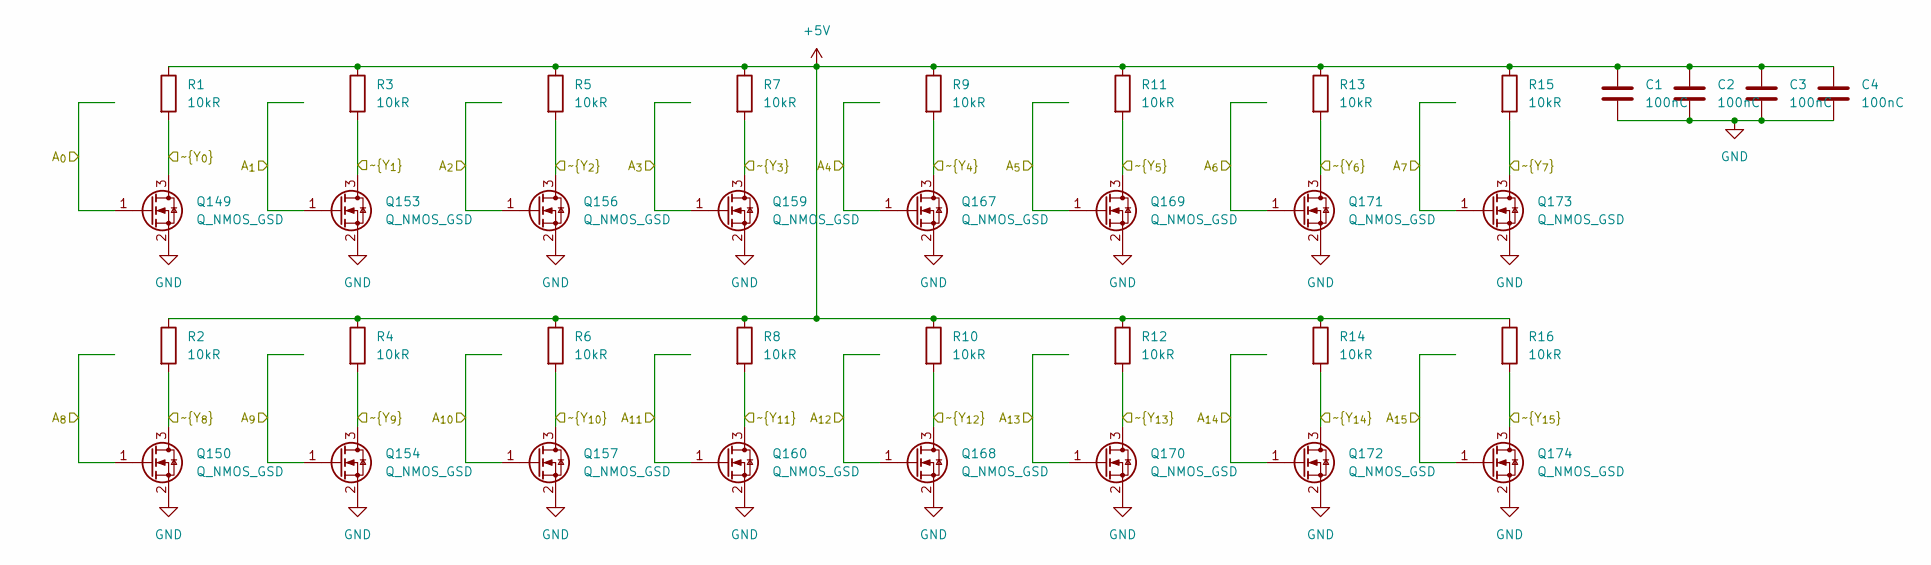
[picture p42: schematic 16_NOT.kicad_sch]

Parts:
C1, C2, C3, C4: 100nC; C_0603_1608Metric
Q149, Q150, Q153, Q154, Q156, Q157, Q159, Q160, Q167, Q168, Q169, Q170, Q171, Q172, Q173, Q174: Q_NMOS_GSD; SOT-23-N; LCSC Part # C49308282
R1, R2, R3, R4, R5, R6, R7, R8, R9, R10, R11, R12, R13, R14, R15, R16: 10kR; R_0603_1608Metric; LCSC Part # C54920960

Connections:
+5V: C1.1, C2.1, C3.1, C4.1, R1.1, R2.1, R3.1, R4.1, R5.1, R6.1, R7.1, R8.1, R9.1, R10.1, R11.1, R12.1, R13.1, R14.1, R15.1, R16.1; also elsewhere on the board
/16_NOT/A_{0}: Q149.1 (G); also elsewhere on the board
/16_NOT/A_{1}: Q153.1 (G); also elsewhere on the board
/16_NOT/A_{2}: Q156.1 (G); also elsewhere on the board
/16_NOT/A_{3}: Q159.1 (G); also elsewhere on the board
/16_NOT/A_{4}: Q167.1 (G); also elsewhere on the board
/16_NOT/A_{5}: Q169.1 (G); also elsewhere on the board
/16_NOT/A_{6}: Q171.1 (G); also elsewhere on the board
/16_NOT/A_{7}: Q173.1 (G); also elsewhere on the board
/16_NOT/A_{8}: Q150.1 (G); also elsewhere on the board
/16_NOT/A_{9}: Q154.1 (G); also elsewhere on the board
/16_NOT/A_{10}: Q157.1 (G); also elsewhere on the board
/16_NOT/A_{11}: Q160.1 (G); also elsewhere on the board
/16_NOT/A_{12}: Q168.1 (G); also elsewhere on the board
/16_NOT/A_{13}: Q170.1 (G); also elsewhere on the board
/16_NOT/A_{14}: Q172.1 (G); also elsewhere on the board
/16_NOT/A_{15}: Q174.1 (G); also elsewhere on the board
/A_{0}: Q149.3 (D), R1.2; also elsewhere on the board
/A_{1}: Q153.3 (D), R3.2; also elsewhere on the board
/A_{2}: Q156.3 (D), R5.2; also elsewhere on the board
/A_{3}: Q159.3 (D), R7.2; also elsewhere on the board
/A_{4}: Q167.3 (D), R9.2; also elsewhere on the board
/A_{5}: Q169.3 (D), R11.2; also elsewhere on the board
/A_{6}: Q171.3 (D), R13.2; also elsewhere on the board
/A_{7}: Q173.3 (D), R15.2; also elsewhere on the board
/A_{8}: Q150.3 (D), R2.2; also elsewhere on the board
/A_{9}: Q154.3 (D), R4.2; also elsewhere on the board
/A_{10}: Q157.3 (D), R6.2; also elsewhere on the board
/A_{11}: Q160.3 (D), R8.2; also elsewhere on the board
/A_{12}: Q168.3 (D), R10.2; also elsewhere on the board
/A_{13}: Q170.3 (D), R12.2; also elsewhere on the board
/A_{14}: Q172.3 (D), R14.2; also elsewhere on the board
/A_{15}: Q174.3 (D), R16.2; also elsewhere on the board
GND: C1.2, C2.2, C3.2, C4.2, Q149.2 (S), Q150.2 (S), Q153.2 (S), Q154.2 (S), Q156.2 (S), Q157.2 (S), Q159.2 (S), Q160.2 (S), Q167.2 (S), Q168.2 (S), Q169.2 (S), Q170.2 (S), Q171.2 (S), Q172.2 (S), Q173.2 (S), Q174.2 (S); also elsewhere on the board

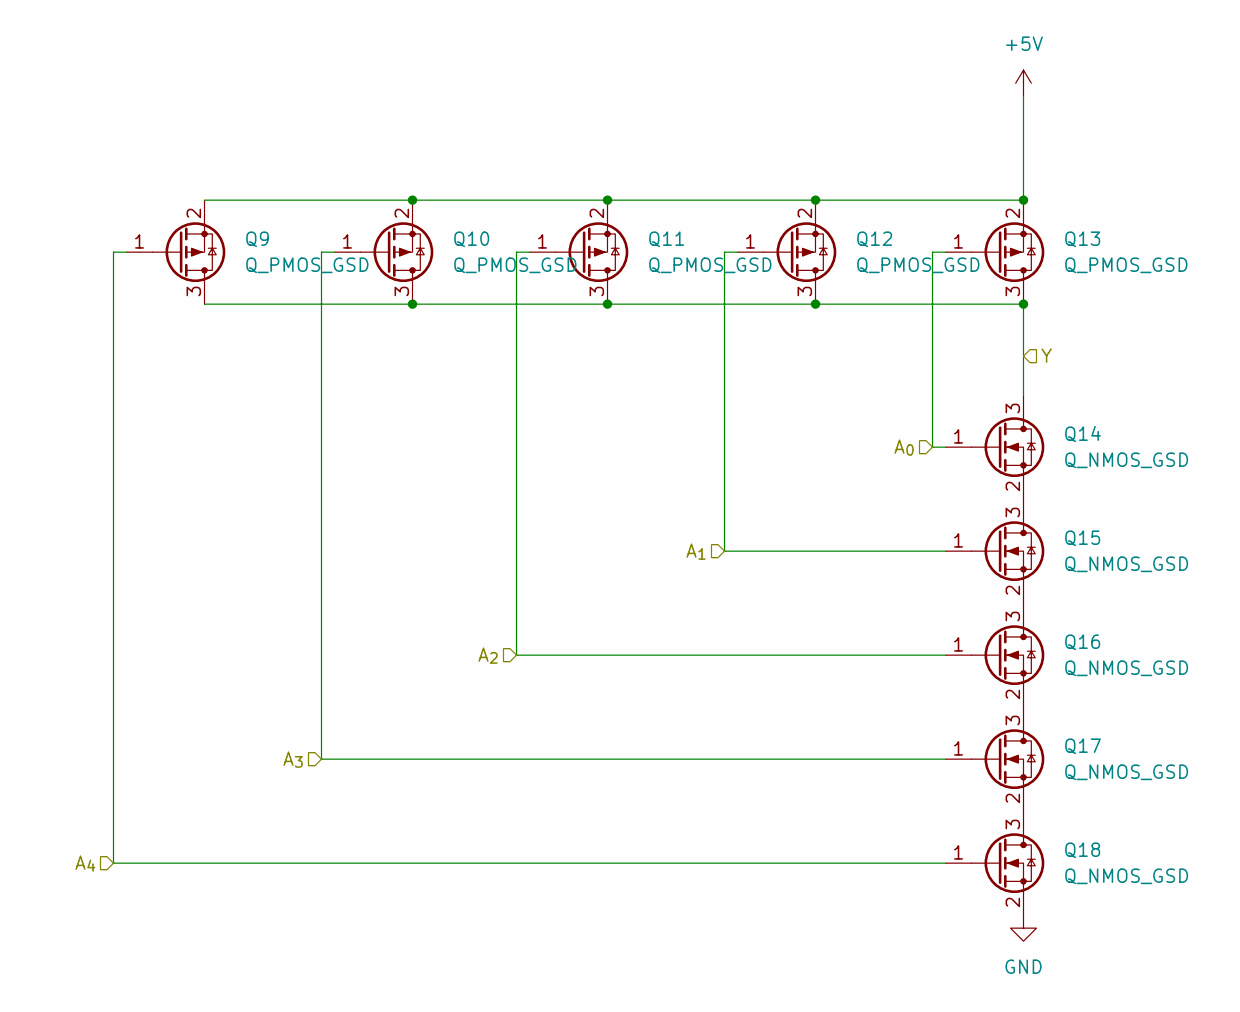
[picture p43: schematic 5V_5NAND.kicad_sch]

Parts:
Q9, Q10, Q11, Q12, Q13: Q_PMOS_GSD; SOT-23-P; LCSC Part # C41384537
Q14, Q15, Q16, Q17, Q18: Q_NMOS_GSD; SOT-23-N; LCSC Part # C49308282

Connections:
+5V: Q9.2 (S), Q10.2 (S), Q11.2 (S), Q12.2 (S), Q13.2 (S); also elsewhere on the board
/1_16_5V_DEMUX_NOTOUT/5VNOT1/Y: Q11.1 (G), Q16.1 (G); also elsewhere on the board
/1_16_5V_DEMUX_NOTOUT/5VNOT2/Y: Q10.1 (G), Q17.1 (G); also elsewhere on the board
/1_16_5V_DEMUX_NOTOUT/5VNOT3/Y: Q9.1 (G), Q18.1 (G); also elsewhere on the board
/1_16_5V_DEMUX_NOTOUT/5VNOT/Y: Q12.1 (G), Q15.1 (G); also elsewhere on the board
/1_16_5V_DEMUX_NOTOUT/D: Q13.1 (G), Q14.1 (G); also elsewhere on the board
/16_NOT/A_{0}: Q9.3 (D), Q10.3 (D), Q11.3 (D), Q12.3 (D), Q13.3 (D), Q14.3 (D); also elsewhere on the board
GND: Q18.2 (S); also elsewhere on the board
unnamed: Q14.2 (S), Q15.3 (D)
unnamed: Q15.2 (S), Q16.3 (D)
unnamed: Q16.2 (S), Q17.3 (D)
unnamed: Q17.2 (S), Q18.3 (D)

Parts of its further copies:
Q19, Q20, Q21, Q22, Q23, Q29, Q30, Q31, Q32, Q33, Q39, Q40, Q41, Q42, Q43, Q49, Q50, Q51, Q52, Q53, Q59, Q60, Q61, Q62, Q63, Q69, Q70, Q71, Q72, Q73, Q79, Q80, Q81, Q82, Q83, Q89, Q90, Q91, Q92, Q93, Q99, Q100, Q101, Q102, Q103, Q109, Q110, Q111, Q112, Q113, Q119, Q120, Q121, Q122, Q123, Q129, Q130, Q131, Q132, Q133, Q139, Q140, Q141, Q142, Q143, Q151, Q152, Q155, Q161, Q175, Q176, Q177, Q178, Q179: Q_PMOS_GSD; SOT-23-P; LCSC Part # C41384537
Q24, Q25, Q26, Q27, Q28, Q34, Q35, Q36, Q37, Q38, Q44, Q45, Q46, Q47, Q48, Q54, Q55, Q56, Q57, Q58, Q64, Q65, Q66, Q67, Q68, Q74, Q75, Q76, Q77, Q78, Q84, Q85, Q86, Q87, Q88, Q94, Q95, Q96, Q97, Q98, Q104, Q105, Q106, Q107, Q108, Q114, Q115, Q116, Q117, Q118, Q124, Q125, Q126, Q127, Q128, Q134, Q135, Q136, Q137, Q138, Q144, Q145, Q146, Q147, Q148, Q164, Q165, Q166, Q180, Q181, Q182, Q183, Q184: Q_NMOS_GSD; SOT-23-N; LCSC Part # C49308282

Connections of its further copies:
+5V: Q19.2 (S), Q20.2 (S), Q21.2 (S), Q22.2 (S), Q23.2 (S), Q29.2 (S), Q30.2 (S), Q31.2 (S), Q32.2 (S), Q33.2 (S), Q39.2 (S), Q40.2 (S), Q41.2 (S), Q42.2 (S), Q43.2 (S), Q49.2 (S), Q50.2 (S), Q51.2 (S), Q52.2 (S), Q53.2 (S), Q59.2 (S), Q60.2 (S), Q61.2 (S), Q62.2 (S), Q63.2 (S), Q69.2 (S), Q70.2 (S), Q71.2 (S), Q72.2 (S), Q73.2 (S), Q79.2 (S), Q80.2 (S), Q81.2 (S), Q82.2 (S), Q83.2 (S), Q89.2 (S), Q90.2 (S), Q91.2 (S), Q92.2 (S), Q93.2 (S), Q99.2 (S), Q100.2 (S), Q101.2 (S), Q102.2 (S), Q103.2 (S), Q109.2 (S), Q110.2 (S), Q111.2 (S), Q112.2 (S), Q113.2 (S), Q119.2 (S), Q120.2 (S), Q121.2 (S), Q122.2 (S), Q123.2 (S), Q129.2 (S), Q130.2 (S), Q131.2 (S), Q132.2 (S), Q133.2 (S), Q139.2 (S), Q140.2 (S), Q141.2 (S), Q142.2 (S), Q143.2 (S), Q151.2 (S), Q152.2 (S), Q155.2 (S), Q161.2 (S), Q175.2 (S), Q176.2 (S), Q177.2 (S), Q178.2 (S), Q179.2 (S); also elsewhere on the board
/1_16_5V_DEMUX_NOTOUT/5VNOT1/Y: Q21.1 (G), Q26.1 (G), Q31.1 (G), Q36.1 (G), Q41.1 (G), Q46.1 (G), Q51.1 (G), Q56.1 (G), Q61.1 (G), Q66.1 (G), Q71.1 (G), Q76.1 (G), Q81.1 (G), Q86.1 (G); also elsewhere on the board
/1_16_5V_DEMUX_NOTOUT/5VNOT2/Y: Q20.1 (G), Q27.1 (G), Q30.1 (G), Q37.1 (G), Q40.1 (G), Q47.1 (G), Q90.1 (G), Q97.1 (G), Q100.1 (G), Q107.1 (G), Q110.1 (G), Q117.1 (G), Q120.1 (G), Q127.1 (G); also elsewhere on the board
/1_16_5V_DEMUX_NOTOUT/5VNOT3/Y: Q19.1 (G), Q28.1 (G), Q49.1 (G), Q58.1 (G), Q59.1 (G), Q68.1 (G), Q89.1 (G), Q98.1 (G), Q99.1 (G), Q108.1 (G), Q129.1 (G), Q138.1 (G), Q139.1 (G), Q148.1 (G); also elsewhere on the board
/1_16_5V_DEMUX_NOTOUT/5VNOT/Y: Q32.1 (G), Q35.1 (G), Q52.1 (G), Q55.1 (G), Q72.1 (G), Q75.1 (G), Q92.1 (G), Q95.1 (G), Q112.1 (G), Q115.1 (G), Q132.1 (G), Q135.1 (G); also elsewhere on the board
/1_16_5V_DEMUX_NOTOUT/D: Q23.1 (G), Q24.1 (G), Q33.1 (G), Q34.1 (G), Q43.1 (G), Q44.1 (G), Q53.1 (G), Q54.1 (G), Q63.1 (G), Q64.1 (G), Q73.1 (G), Q74.1 (G), Q83.1 (G), Q84.1 (G), Q93.1 (G), Q94.1 (G), Q103.1 (G), Q104.1 (G), Q113.1 (G), Q114.1 (G), Q123.1 (G), Q124.1 (G), Q133.1 (G), Q134.1 (G), Q143.1 (G), Q144.1 (G), Q161.1 (G), Q179.1 (G), Q180.1 (G); also elsewhere on the board
/1_16_5V_DEMUX_NOTOUT/S_{0}: Q22.1 (G), Q25.1 (G), Q42.1 (G), Q45.1 (G), Q62.1 (G), Q65.1 (G), Q82.1 (G), Q85.1 (G), Q102.1 (G), Q105.1 (G), Q122.1 (G), Q125.1 (G), Q142.1 (G), Q145.1 (G), Q178.1 (G), Q181.1 (G); also elsewhere on the board
/1_16_5V_DEMUX_NOTOUT/S_{1}: Q91.1 (G), Q96.1 (G), Q101.1 (G), Q106.1 (G), Q111.1 (G), Q116.1 (G), Q121.1 (G), Q126.1 (G), Q131.1 (G), Q136.1 (G), Q141.1 (G), Q146.1 (G), Q155.1 (G), Q164.1 (G), Q177.1 (G), Q182.1 (G); also elsewhere on the board
/1_16_5V_DEMUX_NOTOUT/S_{2}: Q50.1 (G), Q57.1 (G), Q60.1 (G), Q67.1 (G), Q70.1 (G), Q77.1 (G), Q80.1 (G), Q87.1 (G), Q130.1 (G), Q137.1 (G), Q140.1 (G), Q147.1 (G), Q152.1 (G), Q165.1 (G), Q176.1 (G), Q183.1 (G); also elsewhere on the board
/1_16_5V_DEMUX_NOTOUT/S_{3}: Q29.1 (G), Q38.1 (G), Q39.1 (G), Q48.1 (G), Q69.1 (G), Q78.1 (G), Q79.1 (G), Q88.1 (G), Q109.1 (G), Q118.1 (G), Q119.1 (G), Q128.1 (G), Q151.1 (G), Q166.1 (G), Q175.1 (G), Q184.1 (G); also elsewhere on the board
/16_NOT/A_{1}: Q29.3 (D), Q30.3 (D), Q31.3 (D), Q32.3 (D), Q33.3 (D), Q34.3 (D); also elsewhere on the board
/16_NOT/A_{2}: Q49.3 (D), Q50.3 (D), Q51.3 (D), Q52.3 (D), Q53.3 (D), Q54.3 (D); also elsewhere on the board
/16_NOT/A_{3}: Q69.3 (D), Q70.3 (D), Q71.3 (D), Q72.3 (D), Q73.3 (D), Q74.3 (D); also elsewhere on the board
/16_NOT/A_{4}: Q89.3 (D), Q90.3 (D), Q91.3 (D), Q92.3 (D), Q93.3 (D), Q94.3 (D); also elsewhere on the board
/16_NOT/A_{5}: Q109.3 (D), Q110.3 (D), Q111.3 (D), Q112.3 (D), Q113.3 (D), Q114.3 (D); also elsewhere on the board
/16_NOT/A_{6}: Q129.3 (D), Q130.3 (D), Q131.3 (D), Q132.3 (D), Q133.3 (D), Q134.3 (D); also elsewhere on the board
/16_NOT/A_{7}: Q151.3 (D), Q152.3 (D), Q155.3 (D), Q161.3 (D); also elsewhere on the board
/16_NOT/A_{8}: Q19.3 (D), Q20.3 (D), Q21.3 (D), Q22.3 (D), Q23.3 (D), Q24.3 (D); also elsewhere on the board
/16_NOT/A_{9}: Q39.3 (D), Q40.3 (D), Q41.3 (D), Q42.3 (D), Q43.3 (D), Q44.3 (D); also elsewhere on the board
/16_NOT/A_{10}: Q59.3 (D), Q60.3 (D), Q61.3 (D), Q62.3 (D), Q63.3 (D), Q64.3 (D); also elsewhere on the board
/16_NOT/A_{11}: Q79.3 (D), Q80.3 (D), Q81.3 (D), Q82.3 (D), Q83.3 (D), Q84.3 (D); also elsewhere on the board
/16_NOT/A_{12}: Q99.3 (D), Q100.3 (D), Q101.3 (D), Q102.3 (D), Q103.3 (D), Q104.3 (D); also elsewhere on the board
/16_NOT/A_{13}: Q119.3 (D), Q120.3 (D), Q121.3 (D), Q122.3 (D), Q123.3 (D), Q124.3 (D); also elsewhere on the board
/16_NOT/A_{14}: Q139.3 (D), Q140.3 (D), Q141.3 (D), Q142.3 (D), Q143.3 (D), Q144.3 (D); also elsewhere on the board
/16_NOT/A_{15}: Q175.3 (D), Q176.3 (D), Q177.3 (D), Q178.3 (D), Q179.3 (D), Q180.3 (D); also elsewhere on the board
GND: Q28.2 (S), Q38.2 (S), Q48.2 (S), Q58.2 (S), Q68.2 (S), Q78.2 (S), Q88.2 (S), Q98.2 (S), Q108.2 (S), Q118.2 (S), Q128.2 (S), Q138.2 (S), Q148.2 (S), Q166.2 (S), Q184.2 (S); also elsewhere on the board
unnamed: Q24.2 (S), Q25.3 (D)
unnamed: Q25.2 (S), Q26.3 (D)
unnamed: Q26.2 (S), Q27.3 (D)
unnamed: Q27.2 (S), Q28.3 (D)
unnamed: Q34.2 (S), Q35.3 (D)
unnamed: Q35.2 (S), Q36.3 (D)
unnamed: Q36.2 (S), Q37.3 (D)
unnamed: Q37.2 (S), Q38.3 (D)
unnamed: Q44.2 (S), Q45.3 (D)
unnamed: Q45.2 (S), Q46.3 (D)
unnamed: Q46.2 (S), Q47.3 (D)
unnamed: Q47.2 (S), Q48.3 (D)
unnamed: Q54.2 (S), Q55.3 (D)
unnamed: Q55.2 (S), Q56.3 (D)
unnamed: Q56.2 (S), Q57.3 (D)
unnamed: Q57.2 (S), Q58.3 (D)
unnamed: Q64.2 (S), Q65.3 (D)
unnamed: Q65.2 (S), Q66.3 (D)
unnamed: Q66.2 (S), Q67.3 (D)
unnamed: Q67.2 (S), Q68.3 (D)
unnamed: Q74.2 (S), Q75.3 (D)
unnamed: Q75.2 (S), Q76.3 (D)
unnamed: Q76.2 (S), Q77.3 (D)
unnamed: Q77.2 (S), Q78.3 (D)
unnamed: Q84.2 (S), Q85.3 (D)
unnamed: Q85.2 (S), Q86.3 (D)
unnamed: Q86.2 (S), Q87.3 (D)
unnamed: Q87.2 (S), Q88.3 (D)
unnamed: Q94.2 (S), Q95.3 (D)
unnamed: Q95.2 (S), Q96.3 (D)
unnamed: Q96.2 (S), Q97.3 (D)
unnamed: Q97.2 (S), Q98.3 (D)
unnamed: Q104.2 (S), Q105.3 (D)
unnamed: Q105.2 (S), Q106.3 (D)
unnamed: Q106.2 (S), Q107.3 (D)
unnamed: Q107.2 (S), Q108.3 (D)
unnamed: Q114.2 (S), Q115.3 (D)
unnamed: Q115.2 (S), Q116.3 (D)
unnamed: Q116.2 (S), Q117.3 (D)
unnamed: Q117.2 (S), Q118.3 (D)
unnamed: Q124.2 (S), Q125.3 (D)
unnamed: Q125.2 (S), Q126.3 (D)
unnamed: Q126.2 (S), Q127.3 (D)
unnamed: Q127.2 (S), Q128.3 (D)
unnamed: Q134.2 (S), Q135.3 (D)
unnamed: Q135.2 (S), Q136.3 (D)
unnamed: Q136.2 (S), Q137.3 (D)
unnamed: Q137.2 (S), Q138.3 (D)
unnamed: Q144.2 (S), Q145.3 (D)
unnamed: Q145.2 (S), Q146.3 (D)
unnamed: Q146.2 (S), Q147.3 (D)
unnamed: Q147.2 (S), Q148.3 (D)
unnamed 121: Q164.3 (D); also elsewhere on the board
unnamed: Q164.2 (S), Q165.3 (D)
unnamed: Q165.2 (S), Q166.3 (D)
unnamed: Q180.2 (S), Q181.3 (D)
unnamed: Q181.2 (S), Q182.3 (D)
unnamed: Q182.2 (S), Q183.3 (D)
unnamed: Q183.2 (S), Q184.3 (D)

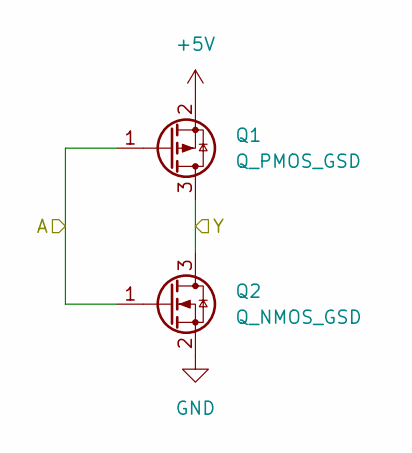
[picture p44: schematic 5VNOT.kicad_sch]

Parts:
Q1: Q_PMOS_GSD; SOT-23-P; LCSC Part # C41384537
Q2: Q_NMOS_GSD; SOT-23-N; LCSC Part # C49308282

Connections:
+5V: Q1.2 (S); also elsewhere on the board
/1_16_5V_DEMUX_NOTOUT/5VNOT/Y: Q1.3 (D), Q2.3 (D); also elsewhere on the board
/1_16_5V_DEMUX_NOTOUT/S_{0}: Q1.1 (G), Q2.1 (G); also elsewhere on the board
GND: Q2.2 (S); also elsewhere on the board

Parts of its further copies:
Q3, Q5, Q7: Q_PMOS_GSD; SOT-23-P; LCSC Part # C41384537
Q4, Q6, Q8: Q_NMOS_GSD; SOT-23-N; LCSC Part # C49308282

Connections of its further copies:
+5V: Q3.2 (S), Q5.2 (S), Q7.2 (S); also elsewhere on the board
/1_16_5V_DEMUX_NOTOUT/5VNOT1/Y: Q3.3 (D), Q4.3 (D); also elsewhere on the board
/1_16_5V_DEMUX_NOTOUT/5VNOT2/Y: Q5.3 (D), Q6.3 (D); also elsewhere on the board
/1_16_5V_DEMUX_NOTOUT/5VNOT3/Y: Q7.3 (D), Q8.3 (D); also elsewhere on the board
/1_16_5V_DEMUX_NOTOUT/S_{1}: Q3.1 (G), Q4.1 (G); also elsewhere on the board
/1_16_5V_DEMUX_NOTOUT/S_{2}: Q5.1 (G), Q6.1 (G); also elsewhere on the board
/1_16_5V_DEMUX_NOTOUT/S_{3}: Q7.1 (G), Q8.1 (G); also elsewhere on the board
GND: Q4.2 (S), Q6.2 (S), Q8.2 (S); also elsewhere on the board

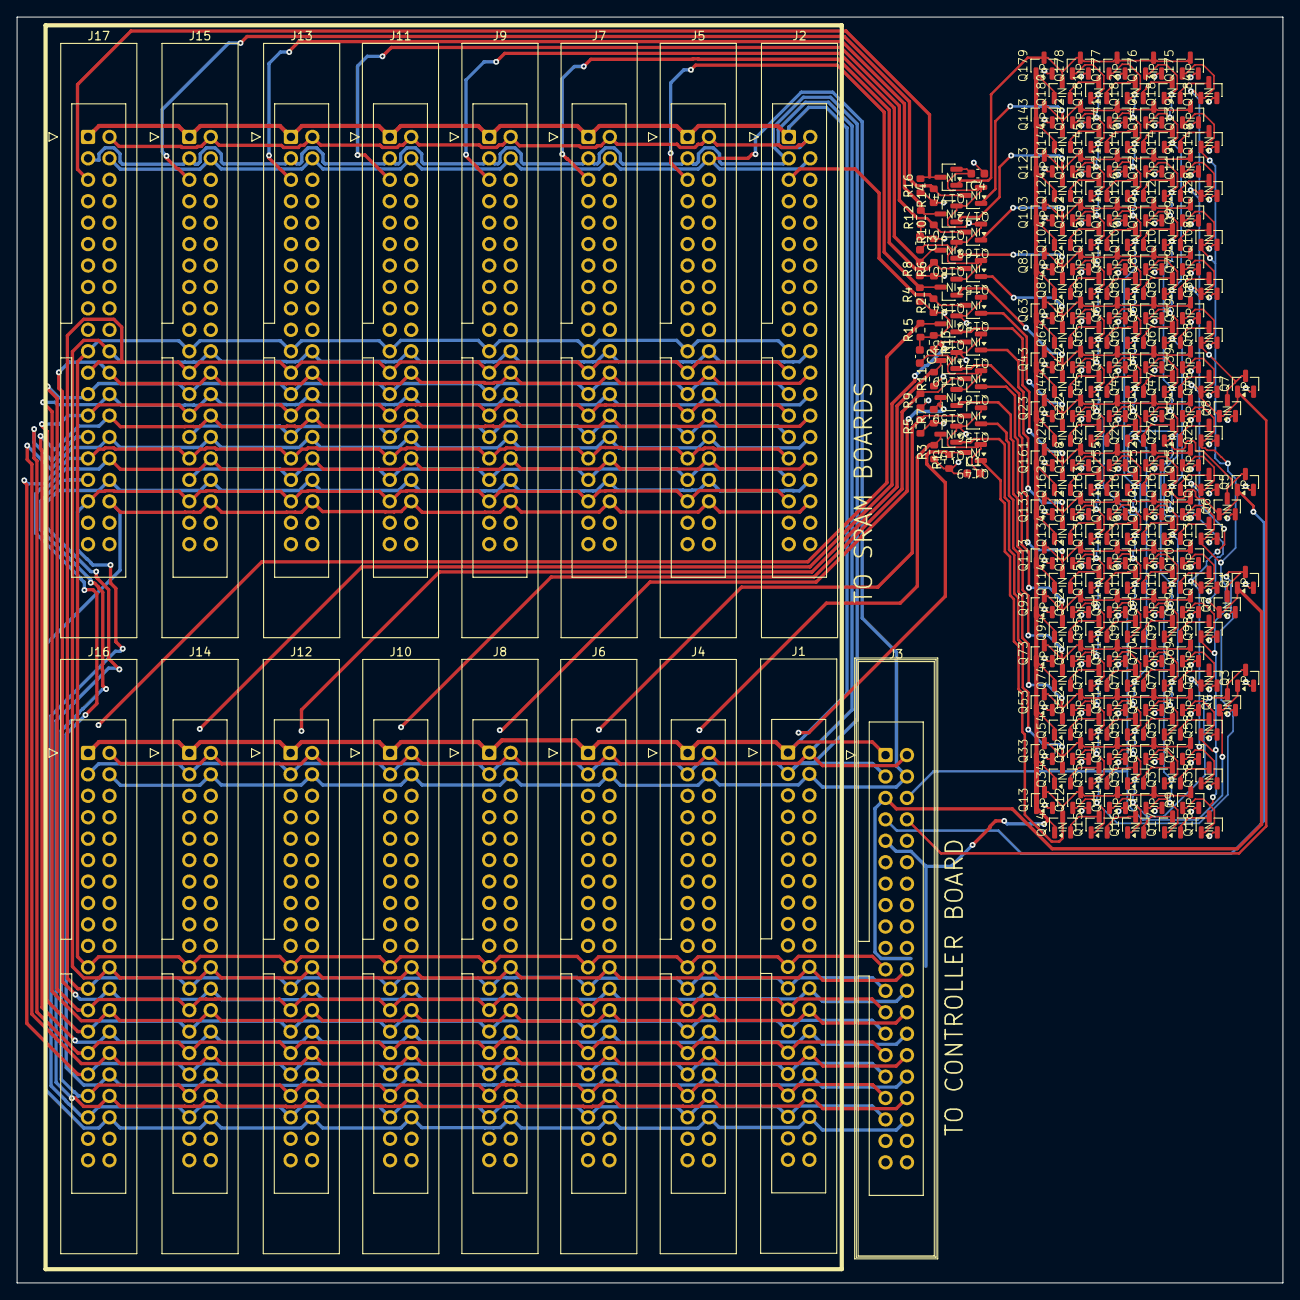
[picture p45: board mainDemuxBoard.kicad_pcb from above]

Board: 4 copper layers, 150.0 x 150.0 mm, 221 parts (0 on the bottom side), 128 nets.

Other parts of the board:
Q158: Q_PMOS_GSD; SOT-23-P
Q162, Q163: Q_NMOS_GSD; SOT-23-N

Their connections:
+5V: Q158.2 (S); also elsewhere on the board
/1_16_5V_DEMUX_NOTOUT/5VNOT/Y: Q158.1 (G), Q163.1 (G); also elsewhere on the board
/1_16_5V_DEMUX_NOTOUT/D: Q162.1 (G); also elsewhere on the board
/16_NOT/A_{7}: Q158.3 (D), Q162.3 (D); also elsewhere on the board
unnamed: Q162.2 (S), Q163.3 (D)
unnamed 121: Q163.2 (S); also elsewhere on the board
