tiydwe/SRAM/kicad/sramBoard/8BIT_ROW/8BIT_ROW.kicad_pcb

## KiCad design kicad/sramBoard/8BIT_ROW/8BIT_ROW.kicad_pcb (2026-10-24)

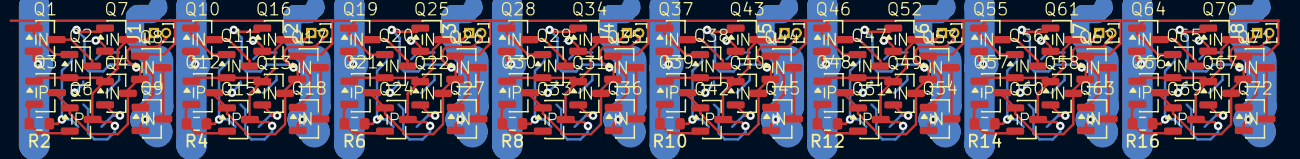
[picture p46: board 8BIT_ROW.kicad_pcb from above]

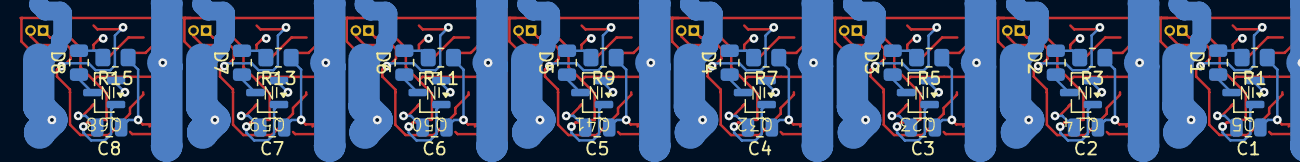
[picture p47: board 8BIT_ROW.kicad_pcb from below]

Board: 4 copper layers, 112 parts (32 on the bottom side), 59 nets.

Parts:
C1, C2, C3, C4, C5, C6, C7, C8: 100nC; C_0805_2012Metric
D1, D2, D3, D4, D5, D6, D7, D8: LED; C_0805_2012Metric
J1, J2, J3, J4, J5, J6, J7, J8: Conn_01x02_Pin; PinHeader_1x02_P1.00mm_Vertical
Q1, Q2, Q4, Q5, Q7, Q8, Q9, Q10, Q11, Q13, Q14, Q16, Q17, Q18, Q19, Q20, Q22, Q23, Q25, Q26, Q27, Q28, Q29, Q31, Q32, Q34, Q35, Q36, Q37, Q38, Q40, Q41, Q43, Q44, Q45, Q46, Q47, Q49, Q50, Q52, Q53, Q54, Q55, Q56, Q58, Q59, Q61, Q62, Q63, Q64, Q65, Q67, Q68, Q70, Q71, Q72: Q_NMOS_GSD; SOT-23-N
Q3, Q6, Q12, Q15, Q21, Q24, Q30, Q33, Q39, Q42, Q48, Q51, Q57, Q60, Q66, Q69: Q_PMOS_GSD; SOT-23-P
R1, R3, R5, R7, R9, R11, R13, R15: 360R; R_0805_2012Metric_Pad1.20x1.40mm_HandSolder
R2, R4, R6, R8, R10, R12, R14, R16: 47R; R_0603_1608Metric

Connections:
+5V: C1.1, C2.1, C3.1, C4.1, C5.1, C6.1, C7.1, C8.1, R1.1, R2.1, R3.1, R4.1, R5.1, R6.1, R7.1, R8.1, R9.1, R10.1, R11.1, R12.1, R13.1, R14.1, R15.1, R16.1
/WL: Q1.1 (G), Q2.1 (G), Q8.1 (G), Q9.1 (G), Q10.1 (G), Q11.1 (G), Q17.1 (G), Q18.1 (G), Q19.1 (G), Q20.1 (G), Q26.1 (G), Q27.1 (G), Q28.1 (G), Q29.1 (G), Q35.1 (G), Q36.1 (G), Q37.1 (G), Q38.1 (G), Q44.1 (G), Q45.1 (G), Q46.1 (G), Q47.1 (G), Q53.1 (G), Q54.1 (G), Q55.1 (G), Q56.1 (G), Q62.1 (G), Q63.1 (G), Q64.1 (G), Q65.1 (G), Q71.1 (G), Q72.1 (G)
GND: C1.2, C2.2, C3.2, C4.2, C5.2, C6.2, C7.2, C8.2, Q4.2 (S), Q5.2 (S), Q7.2 (S), Q13.2 (S), Q14.2 (S), Q16.2 (S), Q22.2 (S), Q23.2 (S), Q25.2 (S), Q31.2 (S), Q32.2 (S), Q34.2 (S), Q40.2 (S), Q41.2 (S), Q43.2 (S), Q49.2 (S), Q50.2 (S), Q52.2 (S), Q58.2 (S), Q59.2 (S), Q61.2 (S), Q67.2 (S), Q68.2 (S), Q70.2 (S)
unnamed: D1.2 (A), R1.2
unnamed: D1.1 (K), Q5.3 (D)
unnamed: D2.2 (A), R3.2
unnamed: D2.1 (K), Q14.3 (D)
unnamed: D3.2 (A), R5.2
unnamed: D3.1 (K), Q23.3 (D)
unnamed: D4.2 (A), R7.2
unnamed: D4.1 (K), Q32.3 (D)
unnamed: D5.2 (A), R9.2
unnamed: D5.1 (K), Q41.3 (D)
unnamed: D6.2 (A), R11.2
unnamed: D6.1 (K), Q50.3 (D)
unnamed: D7.2 (A), R13.2
unnamed: D7.1 (K), Q59.3 (D)
unnamed: D8.2 (A), R15.2
unnamed: D8.1 (K), Q68.3 (D)
unnamed: J1.1, Q2.2 (S), Q3.1 (G), Q4.1 (G), Q5.1 (G), Q6.3 (D), Q7.3 (D)
unnamed: J1.2, Q3.3 (D), Q4.3 (D), Q6.1 (G), Q7.1 (G), Q8.2 (S)
unnamed: J2.1, Q11.2 (S), Q12.1 (G), Q13.1 (G), Q14.1 (G), Q15.3 (D), Q16.3 (D)
unnamed: J2.2, Q12.3 (D), Q13.3 (D), Q15.1 (G), Q16.1 (G), Q17.2 (S)
unnamed: J3.1, Q20.2 (S), Q21.1 (G), Q22.1 (G), Q23.1 (G), Q24.3 (D), Q25.3 (D)
unnamed: J3.2, Q21.3 (D), Q22.3 (D), Q24.1 (G), Q25.1 (G), Q26.2 (S)
unnamed: J4.1, Q29.2 (S), Q30.1 (G), Q31.1 (G), Q32.1 (G), Q33.3 (D), Q34.3 (D)
unnamed: J4.2, Q30.3 (D), Q31.3 (D), Q33.1 (G), Q34.1 (G), Q35.2 (S)
unnamed: J5.1, Q38.2 (S), Q39.1 (G), Q40.1 (G), Q41.1 (G), Q42.3 (D), Q43.3 (D)
unnamed: J5.2, Q39.3 (D), Q40.3 (D), Q42.1 (G), Q43.1 (G), Q44.2 (S)
unnamed: J6.1, Q47.2 (S), Q48.1 (G), Q49.1 (G), Q50.1 (G), Q51.3 (D), Q52.3 (D)
unnamed: J6.2, Q48.3 (D), Q49.3 (D), Q51.1 (G), Q52.1 (G), Q53.2 (S)
unnamed: J7.1, Q56.2 (S), Q57.1 (G), Q58.1 (G), Q59.1 (G), Q60.3 (D), Q61.3 (D)
unnamed: J7.2, Q57.3 (D), Q58.3 (D), Q60.1 (G), Q61.1 (G), Q62.2 (S)
unnamed: J8.1, Q65.2 (S), Q66.1 (G), Q67.1 (G), Q68.1 (G), Q69.3 (D), Q70.3 (D)
unnamed: J8.2, Q66.3 (D), Q67.3 (D), Q69.1 (G), Q70.1 (G), Q71.2 (S)
unnamed: Q1.3 (D), Q2.3 (D)
unnamed: Q3.2 (S), Q6.2 (S), R2.2
unnamed: Q8.3 (D), Q9.3 (D)
unnamed: Q10.3 (D), Q11.3 (D)
unnamed: Q12.2 (S), Q15.2 (S), R4.2
unnamed: Q17.3 (D), Q18.3 (D)
unnamed: Q19.3 (D), Q20.3 (D)
unnamed: Q21.2 (S), Q24.2 (S), R6.2
unnamed: Q26.3 (D), Q27.3 (D)
unnamed: Q28.3 (D), Q29.3 (D)
unnamed: Q30.2 (S), Q33.2 (S), R8.2
unnamed: Q35.3 (D), Q36.3 (D)
unnamed: Q37.3 (D), Q38.3 (D)
unnamed: Q39.2 (S), Q42.2 (S), R10.2
unnamed: Q44.3 (D), Q45.3 (D)
unnamed: Q46.3 (D), Q47.3 (D)
unnamed: Q48.2 (S), Q51.2 (S), R12.2
unnamed: Q53.3 (D), Q54.3 (D)
unnamed: Q55.3 (D), Q56.3 (D)
unnamed: Q57.2 (S), Q60.2 (S), R14.2
unnamed: Q62.3 (D), Q63.3 (D)
unnamed: Q64.3 (D), Q65.3 (D)
unnamed: Q66.2 (S), Q69.2 (S), R16.2
unnamed: Q71.3 (D), Q72.3 (D)
