tiydwe/SRAM/kicad/controllerBoard/WL_PULSE_GEN/WL_PULSE_GEN.kicad_pcb

## KiCad design kicad/controllerBoard/WL_PULSE_GEN/WL_PULSE_GEN.kicad_pcb (2026-10-24)

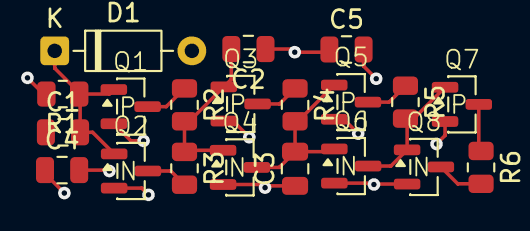
[picture p48: board WL_PULSE_GEN.kicad_pcb from above]

Board: 2 copper layers, 20 parts (0 on the bottom side), 12 nets.

Parts:
C1, C2, C4, C5: 100nC; C_0805_2012Metric
C3: 4.7uC; C_0805_2012Metric
D1: 1N4148; D_DO-35_SOD27_P7.62mm_Horizontal
Q1, Q3, Q5, Q7: Q_PMOS_GSD; SOT-23-P
Q2, Q4, Q6, Q8: Q_NMOS_GSD; SOT-23-N
R1: 100kR; R_0805_2012Metric
R2, R5: 47R; R_0805_2012Metric
R3, R6: 4.7R; R_0805_2012Metric
R4: 4.7kR; R_0805_2012Metric

Connections:
+5V: C4.2, C5.2, Q1.2 (S), Q3.2 (S), Q5.2 (S), Q7.2 (S)
/WL_PULSE: Q8.3 (D), R6.2
GND: C2.1, C3.1, C4.1, C5.1, D1.2 (A), Q2.2 (S), Q4.2 (S), Q6.2 (S), Q8.2 (S), R1.2
unnamed: C1.2, D1.1 (K), Q1.1 (G), Q2.1 (G), R1.1
unnamed: Q1.3 (D), R2.1
unnamed: Q2.3 (D), R3.2
unnamed: Q3.3 (D), R4.1
unnamed: C2.2, Q3.1 (G), Q4.1 (G), R2.2, R3.1
unnamed: C3.2, Q4.3 (D), Q5.1 (G), Q6.1 (G), R4.2
unnamed: Q5.3 (D), R5.1
unnamed: Q6.3 (D), Q7.1 (G), Q8.1 (G), R5.2
unnamed: Q7.3 (D), R6.1
