tiydwe/SRAM/kicad/sramBoard/8BIT_ROW/1BIT_CELL/1BIT_CELL.kicad_pcb

## KiCad design kicad/sramBoard/8BIT_ROW/1BIT_CELL/1BIT_CELL.kicad_pcb (2026-10-24)

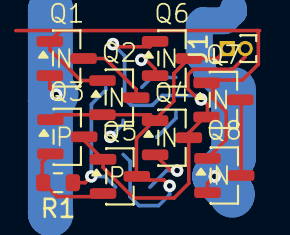
[picture p49: board 1BIT_CELL.kicad_pcb from above]

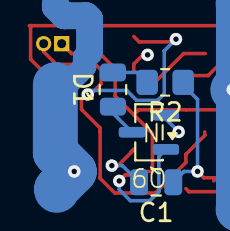
[picture p50: board 1BIT_CELL.kicad_pcb from below]

Board: 4 copper layers, 14 parts (4 on the bottom side), 10 nets.

Parts:
C1: 100nC; C_0805_2012Metric
D1: LED; C_0805_2012Metric
J1: Conn_01x02_Pin; PinHeader_1x02_P1.00mm_Vertical
Q1, Q2, Q4, Q6, Q7, Q8, Q9: Q_NMOS_GSD; SOT-23-N
Q3, Q5: Q_PMOS_GSD; SOT-23-P
R1: 47R; R_0603_1608Metric
R2: 360R; R_0805_2012Metric_Pad1.20x1.40mm_HandSolder

Connections:
+5V: C1.1, R1.1, R2.1
/WL: Q1.1 (G), Q2.1 (G), Q7.1 (G), Q8.1 (G)
GND: C1.2, Q4.2 (S), Q6.2 (S), Q9.2 (S)
unnamed: D1.2 (A), R2.2
unnamed: D1.1 (K), Q9.3 (D)
unnamed: J1.1, Q2.2 (S), Q3.1 (G), Q4.1 (G), Q5.3 (D), Q6.3 (D), Q9.1 (G)
unnamed: J1.2, Q3.3 (D), Q4.3 (D), Q5.1 (G), Q6.1 (G), Q7.2 (S)
unnamed: Q1.3 (D), Q2.3 (D)
unnamed: Q3.2 (S), Q5.2 (S), R1.2
unnamed: Q7.3 (D), Q8.3 (D)
