tiydwe/SRAM/kicad/controllerBoard/RISING_EDGE_DETECTOR/RISING_EDGE_DETECTOR.kicad_pcb

## KiCad design kicad/controllerBoard/RISING_EDGE_DETECTOR/RISING_EDGE_DETECTOR.kicad_pcb (2026-10-24)

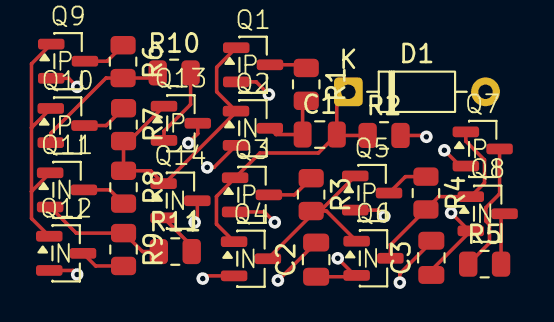
[picture p51: board RISING_EDGE_DETECTOR.kicad_pcb from above]

Board: 2 copper layers, 29 parts (0 on the bottom side), 21 nets.

Parts:
C1, C2, C3: 100nC; C_0805_2012Metric
D1: 1N4148; D_DO-35_SOD27_P7.62mm_Horizontal
Q1, Q3, Q5, Q7, Q9, Q10, Q13: Q_PMOS_GSD; SOT-23-P
Q2, Q4, Q6, Q8, Q11, Q12, Q14: Q_NMOS_GSD; SOT-23-N
R1, R3, R5, R6, R7, R8, R9: 47R; R_0805_2012Metric
R2: 10kR; R_0805_2012Metric
R4: 1R; R_0805_2012Metric
R10, R11: 10R; R_0805_2012Metric

Connections:
+5V: C2.2, C3.2, Q1.2 (S), Q3.2 (S), Q5.2 (S), Q7.2 (S), Q9.2 (S), Q14.3 (D)
/SCHMITT_TRIGGER/V_{out}: Q1.1 (G), Q2.1 (G), Q13.1 (G), Q14.1 (G), R7.2, R8.1
/V_{in}: Q9.1 (G), Q10.1 (G), Q11.1 (G), Q12.1 (G)
/V_{pulse}: Q6.3 (D), Q7.1 (G), Q8.1 (G), R4.2
/~V_{pulse}: Q8.3 (D), R5.2
GND: C2.1, C3.1, D1.2 (A), Q2.2 (S), Q4.2 (S), Q6.2 (S), Q8.2 (S), Q12.2 (S), Q13.3 (D), R2.2
unnamed: C1.2, D1.1 (K), Q3.1 (G), Q4.1 (G), R2.1
unnamed: Q1.3 (D), R1.1
unnamed: C1.1, Q2.3 (D), R1.2
unnamed: Q3.3 (D), R3.1
unnamed: Q4.3 (D), Q5.1 (G), Q6.1 (G), R3.2
unnamed: Q5.3 (D), R4.1
unnamed: Q7.3 (D), R5.1
unnamed: Q9.3 (D), R6.1
unnamed: Q10.3 (D), R7.1
unnamed: Q10.2 (S), R6.2, R10.1
unnamed: Q11.3 (D), R8.2
unnamed: Q11.2 (S), R9.1, R11.1
unnamed: Q12.3 (D), R9.2
unnamed: Q13.2 (S), R10.2
unnamed: Q14.2 (S), R11.2
