tiydwe/SRAM/kicad/controllerBoard/5V_TO_10V/5V_TO_10V.kicad_pcb

## KiCad design kicad/controllerBoard/5V_TO_10V/5V_TO_10V.kicad_pcb (2026-10-21)

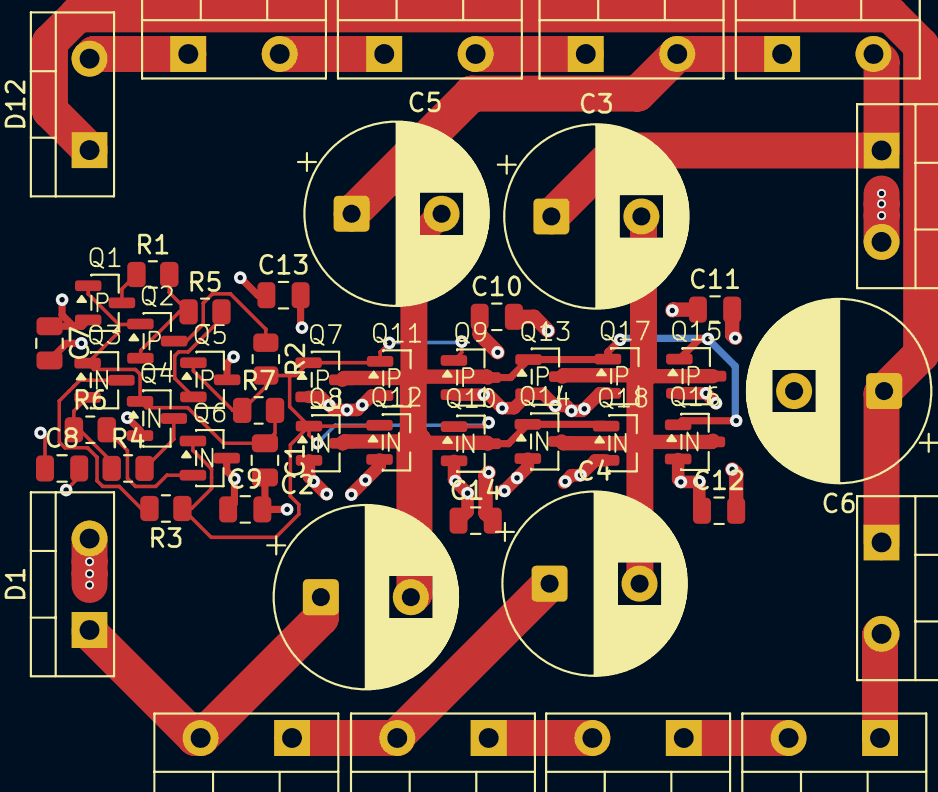
[picture p52: board 5V_TO_10V.kicad_pcb from above]

Board: 2 copper layers, 51 parts (0 on the bottom side), 25 nets.

Parts:
C1, C7, C8, C9, C10, C11, C12, C13, C14: 100nC; C_0805_2012Metric
C2, C3, C4, C5, C6: C_Polarized; CP_Radial_D10.0mm_P5.00mm
D1, D2, D3, D4, D5, D6, D7, D8, D9, D10, D11, D12: MUR1560FAC; TO-220-2_Vertical
Q1, Q2, Q5, Q7, Q9, Q11, Q13, Q15, Q17: Q_PMOS_GSD; SOT-23-P
Q3, Q4, Q6, Q8, Q10, Q12, Q14, Q16, Q18: Q_NMOS_GSD; SOT-23-N
R1, R2, R3, R4: 47R; R_0805_2012Metric
R5, R6: 1R; R_0805_2012Metric
R7: 470R; R_0805_2012Metric

Connections:
+5V: C7.1, C8.1, C9.1, C10.1, C11.2, C12.2, C13.2, C14.2, D1.2 (A), D2.2 (A), Q1.2 (S), Q6.3 (D), Q7.2 (S), Q9.2 (S), Q11.2 (S), Q13.2 (S), Q15.2 (S), Q17.2 (S)
/10V: C6.1, D11.1 (K), D12.1 (K)
GND: C1.2, C6.2, C7.2, C8.2, C9.2, C10.2, C11.1, C12.1, C13.1, C14.1, Q4.2 (S), Q5.3 (D), Q8.2 (S), Q10.2 (S), Q12.2 (S), Q14.2 (S), Q16.2 (S), Q18.2 (S)
unnamed: C2.1, D1.1 (K), D3.2 (A)
unnamed: C3.1, D2.1 (K), D4.2 (A)
unnamed: C4.1, D3.1 (K), D5.2 (A)
unnamed: C5.1, D4.1 (K), D6.2 (A)
unnamed: D5.1 (K), D7.2 (A)
unnamed: D6.1 (K), D8.2 (A)
unnamed: D7.1 (K), D9.2 (A)
unnamed: D8.1 (K), D10.2 (A)
unnamed: D10.1 (K), D12.2 (A)
unnamed: D9.1 (K), D11.2 (A)
unnamed: Q1.3 (D), R1.1
unnamed: C1.1, Q1.1 (G), Q2.1 (G), Q3.1 (G), Q4.1 (G), R7.2
unnamed: Q2.3 (D), R2.1
unnamed: Q2.2 (S), R1.2, R5.1
unnamed: Q3.3 (D), R3.2
unnamed: Q3.2 (S), R4.1, R6.1
unnamed: Q4.3 (D), R4.2
unnamed: Q5.2 (S), R5.2
unnamed: Q6.2 (S), R6.2
unnamed: C2.2, C5.2, Q7.3 (D), Q8.3 (D), Q9.3 (D), Q10.3 (D), Q11.3 (D), Q12.3 (D), Q13.1 (G), Q14.1 (G), Q15.1 (G), Q16.1 (G), Q17.1 (G), Q18.1 (G)
unnamed: Q5.1 (G), Q6.1 (G), Q7.1 (G), Q8.1 (G), Q9.1 (G), Q10.1 (G), Q11.1 (G), Q12.1 (G), R2.2, R3.1, R7.1
unnamed: C3.2, C4.2, Q13.3 (D), Q14.3 (D), Q15.3 (D), Q16.3 (D), Q17.3 (D), Q18.3 (D)
