tiydwe/SRAM/kicad/controllerBoard/8DLATCH/dlatch/dlatch.kicad_pcb

## KiCad design kicad/controllerBoard/8DLATCH/dlatch/dlatch.kicad_pcb (2026-10-21)

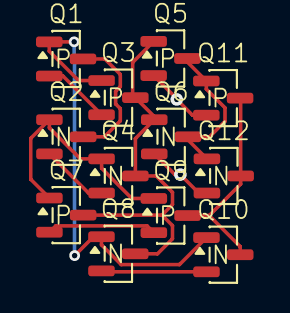
[picture p53: board dlatch.kicad_pcb from above]

Board: 2 copper layers, 12 parts (0 on the bottom side), 12 nets.

Parts:
Q1, Q3, Q5, Q7, Q9, Q11: Q_PMOS_GSD; SOT-23-P
Q2, Q4, Q6, Q8, Q10, Q12: Q_NMOS_GSD; SOT-23-N

Connections:
+5V: Q5.2 (S), Q11.2 (S)
/D: Q1.3 (D), Q2.3 (D)
/EN: Q2.1 (G), Q4.1 (G), Q7.1 (G), Q9.1 (G)
/Q: Q9.3 (D), Q10.3 (D), Q11.3 (D), Q12.3 (D)
/~EN: Q1.1 (G), Q3.1 (G), Q8.1 (G), Q10.1 (G)
/~Q: Q5.3 (D), Q6.3 (D), Q11.1 (G), Q12.1 (G)
GND: Q6.2 (S), Q12.2 (S)
unnamed: Q1.2 (S), Q3.2 (S)
unnamed: Q2.2 (S), Q4.2 (S)
unnamed: Q3.3 (D), Q4.3 (D), Q5.1 (G), Q6.1 (G), Q7.3 (D), Q8.3 (D)
unnamed: Q7.2 (S), Q9.2 (S)
unnamed: Q8.2 (S), Q10.2 (S)
