tiydwe/SRAM/kicad/controllerBoard/8DLATCH/8DLATCH.kicad_pcb

## KiCad design kicad/controllerBoard/8DLATCH/8DLATCH.kicad_pcb (2026-10-21)

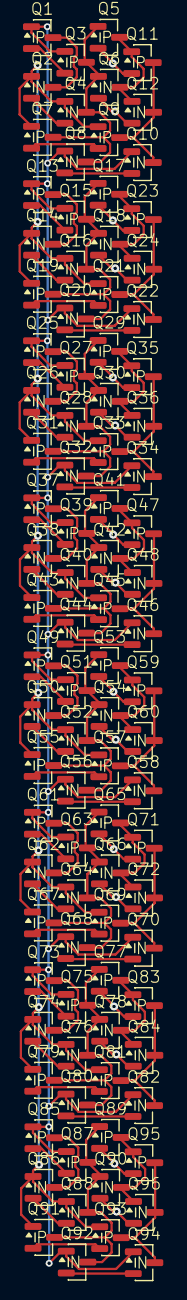
[picture p54: board 8DLATCH.kicad_pcb from above]

Board: 2 copper layers, 96 parts (0 on the bottom side), 82 nets.

Parts:
Q1, Q3, Q5, Q7, Q9, Q11, Q13, Q15, Q17, Q19, Q21, Q23, Q25, Q27, Q29, Q31, Q33, Q35, Q37, Q39, Q41, Q43, Q45, Q47, Q49, Q51, Q53, Q55, Q57, Q59, Q61, Q63, Q65, Q67, Q69, Q71, Q73, Q75, Q77, Q79, Q81, Q83, Q85, Q87, Q89, Q91, Q93, Q95: Q_PMOS_GSD; SOT-23-P
Q2, Q4, Q6, Q8, Q10, Q12, Q14, Q16, Q18, Q20, Q22, Q24, Q26, Q28, Q30, Q32, Q34, Q36, Q38, Q40, Q42, Q44, Q46, Q48, Q50, Q52, Q54, Q56, Q58, Q60, Q62, Q64, Q66, Q68, Q70, Q72, Q74, Q76, Q78, Q80, Q82, Q84, Q86, Q88, Q90, Q92, Q94, Q96: Q_NMOS_GSD; SOT-23-N

Connections:
/D_{0}: Q1.3 (D), Q2.3 (D)
/D_{1}: Q13.3 (D), Q14.3 (D)
/D_{2}: Q25.3 (D), Q26.3 (D)
/D_{3}: Q37.3 (D), Q38.3 (D)
/D_{4}: Q49.3 (D), Q50.3 (D)
/D_{5}: Q61.3 (D), Q62.3 (D)
/D_{6}: Q73.3 (D), Q74.3 (D)
/D_{7}: Q85.3 (D), Q86.3 (D)
/EN: Q2.1 (G), Q4.1 (G), Q7.1 (G), Q9.1 (G), Q14.1 (G), Q16.1 (G), Q19.1 (G), Q21.1 (G), Q26.1 (G), Q28.1 (G), Q31.1 (G), Q33.1 (G), Q38.1 (G), Q40.1 (G), Q43.1 (G), Q45.1 (G), Q50.1 (G), Q52.1 (G), Q55.1 (G), Q57.1 (G), Q62.1 (G), Q64.1 (G), Q67.1 (G), Q69.1 (G), Q74.1 (G), Q76.1 (G), Q79.1 (G), Q81.1 (G), Q86.1 (G), Q88.1 (G), Q91.1 (G), Q93.1 (G)
/Q_{0}: Q9.3 (D), Q10.3 (D), Q11.3 (D), Q12.3 (D)
/Q_{1}: Q21.3 (D), Q22.3 (D), Q23.3 (D), Q24.3 (D)
/Q_{2}: Q33.3 (D), Q34.3 (D), Q35.3 (D), Q36.3 (D)
/Q_{3}: Q45.3 (D), Q46.3 (D), Q47.3 (D), Q48.3 (D)
/Q_{4}: Q57.3 (D), Q58.3 (D), Q59.3 (D), Q60.3 (D)
/Q_{5}: Q69.3 (D), Q70.3 (D), Q71.3 (D), Q72.3 (D)
/Q_{6}: Q81.3 (D), Q82.3 (D), Q83.3 (D), Q84.3 (D)
/Q_{7}: Q93.3 (D), Q94.3 (D), Q95.3 (D), Q96.3 (D)
/~EN: Q1.1 (G), Q3.1 (G), Q8.1 (G), Q10.1 (G), Q13.1 (G), Q15.1 (G), Q20.1 (G), Q22.1 (G), Q25.1 (G), Q27.1 (G), Q32.1 (G), Q34.1 (G), Q37.1 (G), Q39.1 (G), Q44.1 (G), Q46.1 (G), Q49.1 (G), Q51.1 (G), Q56.1 (G), Q58.1 (G), Q61.1 (G), Q63.1 (G), Q68.1 (G), Q70.1 (G), Q73.1 (G), Q75.1 (G), Q80.1 (G), Q82.1 (G), Q85.1 (G), Q87.1 (G), Q92.1 (G), Q94.1 (G)
/~Q_{0}: Q5.3 (D), Q6.3 (D), Q11.1 (G), Q12.1 (G)
/~Q_{1}: Q17.3 (D), Q18.3 (D), Q23.1 (G), Q24.1 (G)
/~Q_{2}: Q29.3 (D), Q30.3 (D), Q35.1 (G), Q36.1 (G)
/~Q_{3}: Q41.3 (D), Q42.3 (D), Q47.1 (G), Q48.1 (G)
/~Q_{4}: Q53.3 (D), Q54.3 (D), Q59.1 (G), Q60.1 (G)
/~Q_{5}: Q65.3 (D), Q66.3 (D), Q71.1 (G), Q72.1 (G)
/~Q_{6}: Q77.3 (D), Q78.3 (D), Q83.1 (G), Q84.1 (G)
/~Q_{7}: Q89.3 (D), Q90.3 (D), Q95.1 (G), Q96.1 (G)
unnamed: Q1.2 (S), Q3.2 (S)
unnamed: Q2.2 (S), Q4.2 (S)
unnamed: Q3.3 (D), Q4.3 (D), Q5.1 (G), Q6.1 (G), Q7.3 (D), Q8.3 (D)
unnamed: Q7.2 (S), Q9.2 (S)
unnamed: Q8.2 (S), Q10.2 (S)
unnamed: Q5.2 (S), Q11.2 (S)
unnamed: Q6.2 (S), Q12.2 (S)
unnamed: Q13.2 (S), Q15.2 (S)
unnamed: Q14.2 (S), Q16.2 (S)
unnamed: Q15.3 (D), Q16.3 (D), Q17.1 (G), Q18.1 (G), Q19.3 (D), Q20.3 (D)
unnamed: Q17.2 (S), Q23.2 (S)
unnamed: Q18.2 (S), Q24.2 (S)
unnamed: Q19.2 (S), Q21.2 (S)
unnamed: Q20.2 (S), Q22.2 (S)
unnamed: Q25.2 (S), Q27.2 (S)
unnamed: Q26.2 (S), Q28.2 (S)
unnamed: Q27.3 (D), Q28.3 (D), Q29.1 (G), Q30.1 (G), Q31.3 (D), Q32.3 (D)
unnamed: Q29.2 (S), Q35.2 (S)
unnamed: Q30.2 (S), Q36.2 (S)
unnamed: Q31.2 (S), Q33.2 (S)
unnamed: Q32.2 (S), Q34.2 (S)
unnamed: Q37.2 (S), Q39.2 (S)
unnamed: Q38.2 (S), Q40.2 (S)
unnamed: Q39.3 (D), Q40.3 (D), Q41.1 (G), Q42.1 (G), Q43.3 (D), Q44.3 (D)
unnamed: Q41.2 (S), Q47.2 (S)
unnamed: Q42.2 (S), Q48.2 (S)
unnamed: Q43.2 (S), Q45.2 (S)
unnamed: Q44.2 (S), Q46.2 (S)
unnamed: Q49.2 (S), Q51.2 (S)
unnamed: Q50.2 (S), Q52.2 (S)
unnamed: Q51.3 (D), Q52.3 (D), Q53.1 (G), Q54.1 (G), Q55.3 (D), Q56.3 (D)
unnamed: Q53.2 (S), Q59.2 (S)
unnamed: Q54.2 (S), Q60.2 (S)
unnamed: Q55.2 (S), Q57.2 (S)
unnamed: Q56.2 (S), Q58.2 (S)
unnamed: Q61.2 (S), Q63.2 (S)
unnamed: Q62.2 (S), Q64.2 (S)
unnamed: Q63.3 (D), Q64.3 (D), Q65.1 (G), Q66.1 (G), Q67.3 (D), Q68.3 (D)
unnamed: Q65.2 (S), Q71.2 (S)
unnamed: Q66.2 (S), Q72.2 (S)
unnamed: Q67.2 (S), Q69.2 (S)
unnamed: Q68.2 (S), Q70.2 (S)
unnamed: Q73.2 (S), Q75.2 (S)
unnamed: Q74.2 (S), Q76.2 (S)
unnamed: Q75.3 (D), Q76.3 (D), Q77.1 (G), Q78.1 (G), Q79.3 (D), Q80.3 (D)
unnamed: Q77.2 (S), Q83.2 (S)
unnamed: Q78.2 (S), Q84.2 (S)
unnamed: Q79.2 (S), Q81.2 (S)
unnamed: Q80.2 (S), Q82.2 (S)
unnamed: Q85.2 (S), Q87.2 (S)
unnamed: Q86.2 (S), Q88.2 (S)
unnamed: Q87.3 (D), Q88.3 (D), Q89.1 (G), Q90.1 (G), Q91.3 (D), Q92.3 (D)
unnamed: Q89.2 (S), Q95.2 (S)
unnamed: Q90.2 (S), Q96.2 (S)
unnamed: Q91.2 (S), Q93.2 (S)
unnamed: Q92.2 (S), Q94.2 (S)
