tiydwe/SRAM/kicad/controllerBoard/8NOT/8NOT.kicad_pcb

## KiCad design kicad/controllerBoard/8NOT/8NOT.kicad_pcb (2026-10-18)

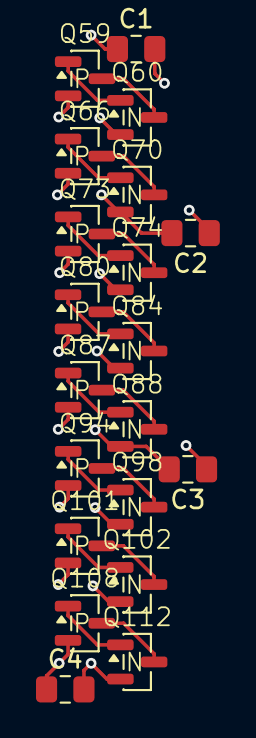
[picture p55: board 8NOT.kicad_pcb from above]

Board: 2 copper layers, 20 parts (0 on the bottom side), 18 nets.

Parts:
C1, C2, C3, C4: C; C_0805_2012Metric_Pad1.18x1.45mm_HandSolder
Q59, Q66, Q73, Q80, Q87, Q94, Q101, Q108: Q_PMOS_GSD; SOT-23-P
Q60, Q70, Q74, Q84, Q88, Q98, Q102, Q112: Q_NMOS_GSD; SOT-23-N

Connections:
+5V: C1.1, C2.1, C3.1, C4.1, Q59.2 (S), Q66.2 (S), Q73.2 (S), Q80.2 (S), Q87.2 (S), Q94.2 (S), Q101.2 (S), Q108.2 (S)
/A_{0}: Q59.1 (G), Q60.1 (G)
/A_{1}: Q66.1 (G), Q70.1 (G)
/A_{2}: Q73.1 (G), Q74.1 (G)
/A_{3}: Q80.1 (G), Q84.1 (G)
/A_{4}: Q87.1 (G), Q88.1 (G)
/A_{5}: Q94.1 (G), Q98.1 (G)
/A_{6}: Q101.1 (G), Q102.1 (G)
/A_{7}: Q108.1 (G), Q112.1 (G)
/~A_{0}: Q59.3 (D), Q60.3 (D)
/~A_{1}: Q66.3 (D), Q70.3 (D)
/~A_{2}: Q73.3 (D), Q74.3 (D)
/~A_{3}: Q80.3 (D), Q84.3 (D)
/~A_{4}: Q87.3 (D), Q88.3 (D)
/~A_{5}: Q94.3 (D), Q98.3 (D)
/~A_{6}: Q101.3 (D), Q102.3 (D)
/~A_{7}: Q108.3 (D), Q112.3 (D)
GND: C1.2, C2.2, C3.2, C4.2, Q60.2 (S), Q70.2 (S), Q74.2 (S), Q84.2 (S), Q88.2 (S), Q98.2 (S), Q102.2 (S), Q112.2 (S)
