tiydwe/SRAM/kicad/controllerBoard/8_1TO2_DEMUX/1TO2_DEMUX/1TO2_DEMUX.kicad_pcb

## KiCad design kicad/controllerBoard/8_1TO2_DEMUX/1TO2_DEMUX/1TO2_DEMUX.kicad_pcb (2026-10-18)

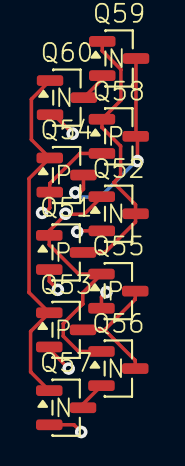
[picture p56: board 1TO2_DEMUX.kicad_pcb from above]

Board: 2 copper layers, 10 parts (0 on the bottom side), 9 nets.

Parts:
Q51, Q53, Q54, Q55, Q58: Q_PMOS_GSD; SOT-23-P
Q52, Q56, Q57, Q59, Q60: Q_NMOS_GSD; SOT-23-N

Connections:
+5V: Q51.2 (S), Q53.2 (S), Q54.2 (S), Q55.2 (S), Q58.2 (S)
/Addr: Q51.1 (G), Q52.1 (G), Q55.1 (G), Q56.1 (G)
/D: Q53.1 (G), Q54.1 (G), Q57.1 (G), Q60.1 (G)
/~Y_{0}: Q54.3 (D), Q58.3 (D), Q59.3 (D)
/~Y_{1}: Q53.3 (D), Q55.3 (D), Q56.3 (D)
GND: Q52.2 (S), Q57.2 (S), Q60.2 (S)
unnamed: Q51.3 (D), Q52.3 (D), Q58.1 (G), Q59.1 (G)
unnamed: Q56.2 (S), Q57.3 (D)
unnamed: Q59.2 (S), Q60.3 (D)
