tiydwe/SRAM/kicad/controllerBoard/8_1TO2_DEMUX/8_1TO2_DEMUX.kicad_pcb

## KiCad design kicad/controllerBoard/8_1TO2_DEMUX/8_1TO2_DEMUX.kicad_pcb (2026-10-18)

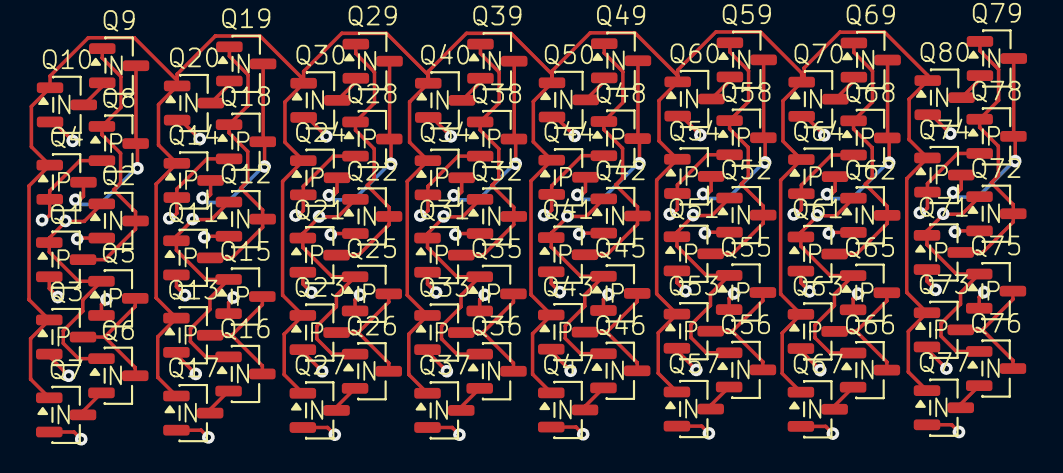
[picture p57: board 8_1TO2_DEMUX.kicad_pcb from above]

Board: 2 copper layers, 80 parts (0 on the bottom side), 51 nets.

Parts:
Q1, Q3, Q4, Q5, Q8, Q11, Q13, Q14, Q15, Q18, Q21, Q23, Q24, Q25, Q28, Q31, Q33, Q34, Q35, Q38, Q41, Q43, Q44, Q45, Q48, Q51, Q53, Q54, Q55, Q58, Q61, Q63, Q64, Q65, Q68, Q71, Q73, Q74, Q75, Q78: Q_PMOS_GSD; SOT-23-P
Q2, Q6, Q7, Q9, Q10, Q12, Q16, Q17, Q19, Q20, Q22, Q26, Q27, Q29, Q30, Q32, Q36, Q37, Q39, Q40, Q42, Q46, Q47, Q49, Q50, Q52, Q56, Q57, Q59, Q60, Q62, Q66, Q67, Q69, Q70, Q72, Q76, Q77, Q79, Q80: Q_NMOS_GSD; SOT-23-N

Connections:
+5V: Q1.2 (S), Q3.2 (S), Q4.2 (S), Q5.2 (S), Q8.2 (S), Q11.2 (S), Q13.2 (S), Q14.2 (S), Q15.2 (S), Q18.2 (S), Q21.2 (S), Q23.2 (S), Q24.2 (S), Q25.2 (S), Q28.2 (S), Q31.2 (S), Q33.2 (S), Q34.2 (S), Q35.2 (S), Q38.2 (S), Q41.2 (S), Q43.2 (S), Q44.2 (S), Q45.2 (S), Q48.2 (S), Q51.2 (S), Q53.2 (S), Q54.2 (S), Q55.2 (S), Q58.2 (S), Q61.2 (S), Q63.2 (S), Q64.2 (S), Q65.2 (S), Q68.2 (S), Q71.2 (S), Q73.2 (S), Q74.2 (S), Q75.2 (S), Q78.2 (S)
/Addr_{0}: Q1.1 (G), Q2.1 (G), Q5.1 (G), Q6.1 (G)
/Addr_{1}: Q11.1 (G), Q12.1 (G), Q15.1 (G), Q16.1 (G)
/Addr_{2}: Q21.1 (G), Q22.1 (G), Q25.1 (G), Q26.1 (G)
/Addr_{3}: Q31.1 (G), Q32.1 (G), Q35.1 (G), Q36.1 (G)
/Addr_{4}: Q41.1 (G), Q42.1 (G), Q45.1 (G), Q46.1 (G)
/Addr_{5}: Q51.1 (G), Q52.1 (G), Q55.1 (G), Q56.1 (G)
/Addr_{6}: Q61.1 (G), Q62.1 (G), Q65.1 (G), Q66.1 (G)
/Addr_{7}: Q71.1 (G), Q72.1 (G), Q75.1 (G), Q76.1 (G)
/D: Q3.1 (G), Q4.1 (G), Q7.1 (G), Q10.1 (G), Q13.1 (G), Q14.1 (G), Q17.1 (G), Q20.1 (G), Q23.1 (G), Q24.1 (G), Q27.1 (G), Q30.1 (G), Q33.1 (G), Q34.1 (G), Q37.1 (G), Q40.1 (G), Q43.1 (G), Q44.1 (G), Q47.1 (G), Q50.1 (G), Q53.1 (G), Q54.1 (G), Q57.1 (G), Q60.1 (G), Q63.1 (G), Q64.1 (G), Q67.1 (G), Q70.1 (G), Q73.1 (G), Q74.1 (G), Q77.1 (G), Q80.1 (G)
/~Y_{0 0}: Q4.3 (D), Q8.3 (D), Q9.3 (D)
/~Y_{0 1}: Q14.3 (D), Q18.3 (D), Q19.3 (D)
/~Y_{0 2}: Q24.3 (D), Q28.3 (D), Q29.3 (D)
/~Y_{0 3}: Q34.3 (D), Q38.3 (D), Q39.3 (D)
/~Y_{0 4}: Q44.3 (D), Q48.3 (D), Q49.3 (D)
/~Y_{0 5}: Q54.3 (D), Q58.3 (D), Q59.3 (D)
/~Y_{0 6}: Q64.3 (D), Q68.3 (D), Q69.3 (D)
/~Y_{0 7}: Q74.3 (D), Q78.3 (D), Q79.3 (D)
/~Y_{1 0}: Q3.3 (D), Q5.3 (D), Q6.3 (D)
/~Y_{1 1}: Q13.3 (D), Q15.3 (D), Q16.3 (D)
/~Y_{1 2}: Q23.3 (D), Q25.3 (D), Q26.3 (D)
/~Y_{1 3}: Q33.3 (D), Q35.3 (D), Q36.3 (D)
/~Y_{1 4}: Q43.3 (D), Q45.3 (D), Q46.3 (D)
/~Y_{1 5}: Q53.3 (D), Q55.3 (D), Q56.3 (D)
/~Y_{1 6}: Q63.3 (D), Q65.3 (D), Q66.3 (D)
/~Y_{1 7}: Q73.3 (D), Q75.3 (D), Q76.3 (D)
GND: Q2.2 (S), Q7.2 (S), Q10.2 (S), Q12.2 (S), Q17.2 (S), Q20.2 (S), Q22.2 (S), Q27.2 (S), Q30.2 (S), Q32.2 (S), Q37.2 (S), Q40.2 (S), Q42.2 (S), Q47.2 (S), Q50.2 (S), Q52.2 (S), Q57.2 (S), Q60.2 (S), Q62.2 (S), Q67.2 (S), Q70.2 (S), Q72.2 (S), Q77.2 (S), Q80.2 (S)
unnamed: Q1.3 (D), Q2.3 (D), Q8.1 (G), Q9.1 (G)
unnamed: Q6.2 (S), Q7.3 (D)
unnamed: Q9.2 (S), Q10.3 (D)
unnamed: Q11.3 (D), Q12.3 (D), Q18.1 (G), Q19.1 (G)
unnamed: Q16.2 (S), Q17.3 (D)
unnamed: Q19.2 (S), Q20.3 (D)
unnamed: Q21.3 (D), Q22.3 (D), Q28.1 (G), Q29.1 (G)
unnamed: Q26.2 (S), Q27.3 (D)
unnamed: Q29.2 (S), Q30.3 (D)
unnamed: Q31.3 (D), Q32.3 (D), Q38.1 (G), Q39.1 (G)
unnamed: Q36.2 (S), Q37.3 (D)
unnamed: Q39.2 (S), Q40.3 (D)
unnamed: Q41.3 (D), Q42.3 (D), Q48.1 (G), Q49.1 (G)
unnamed: Q46.2 (S), Q47.3 (D)
unnamed: Q49.2 (S), Q50.3 (D)
unnamed: Q51.3 (D), Q52.3 (D), Q58.1 (G), Q59.1 (G)
unnamed: Q56.2 (S), Q57.3 (D)
unnamed: Q59.2 (S), Q60.3 (D)
unnamed: Q61.3 (D), Q62.3 (D), Q68.1 (G), Q69.1 (G)
unnamed: Q66.2 (S), Q67.3 (D)
unnamed: Q69.2 (S), Q70.3 (D)
unnamed: Q71.3 (D), Q72.3 (D), Q78.1 (G), Q79.1 (G)
unnamed: Q76.2 (S), Q77.3 (D)
unnamed: Q79.2 (S), Q80.3 (D)
