tiydwe/SRAM/kicad/controllerBoard/8_BL_CTRLR/8_BL_CTRLR.kicad_pcb

## KiCad design kicad/controllerBoard/8_BL_CTRLR/8_BL_CTRLR.kicad_pcb (2026-10-18)

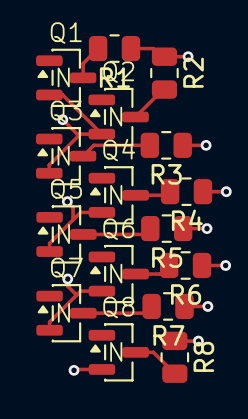
[picture p58: board 8_BL_CTRLR.kicad_pcb from above]

Board: 2 copper layers, 16 parts (0 on the bottom side), 10 nets.

Parts:
Q1, Q2, Q3, Q4, Q5, Q6, Q7, Q8: Q_NMOS_GSD; SOT-23-N
R1, R2, R3, R4, R5, R6, R7, R8: 10kR; R_0805_2012Metric

Connections:
+5V: R1.1, R2.1, R3.1, R4.1, R5.1, R6.1, R7.1, R8.1
/BL_{0}: Q1.3 (D), R1.2
/BL_{1}: Q2.3 (D), R2.2
/BL_{2}: Q3.3 (D), R3.2
/BL_{3}: Q4.3 (D), R4.2
/BL_{4}: Q5.3 (D), R5.2
/BL_{5}: Q6.3 (D), R6.2
/BL_{6}: Q7.3 (D), R7.2
/BL_{7}: Q8.3 (D), R8.2
GND: Q1.2 (S), Q2.2 (S), Q3.2 (S), Q4.2 (S), Q5.2 (S), Q6.2 (S), Q7.2 (S), Q8.2 (S)
