tiydwe/SRAM/kicad/mainDemuxBoard/16_NOT/16_NOT.kicad_pcb

## KiCad design kicad/mainDemuxBoard/16_NOT/16_NOT.kicad_pcb (2026-10-17)

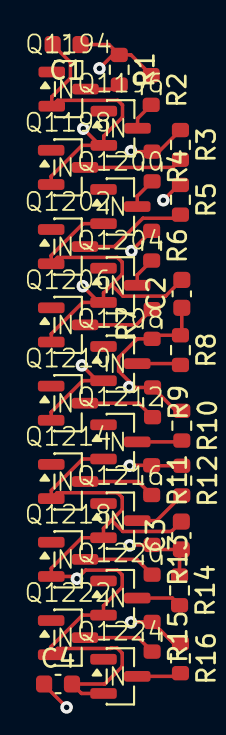
[picture p59: board 16_NOT.kicad_pcb from above]

Board: 4 copper layers, 36 parts (0 on the bottom side), 18 nets.

Parts:
C1, C2, C3, C4: 100nC; C_0603_1608Metric
Q1194, Q1196, Q1198, Q1200, Q1202, Q1204, Q1206, Q1208, Q1210, Q1212, Q1214, Q1216, Q1218, Q1220, Q1222, Q1224: Q_NMOS_GSD; SOT-23-N
R1, R2, R3, R4, R5, R6, R7, R8, R9, R10, R11, R12, R13, R14, R15, R16: 10kR; R_0603_1608Metric

Connections:
+5V: C1.1, C2.1, C3.1, C4.1, R1.1, R2.1, R3.1, R4.1, R5.1, R6.1, R7.1, R8.1, R9.1, R10.1, R11.1, R12.1, R13.1, R14.1, R15.1, R16.1
/~Y_{0}: Q1194.3 (D), R1.2
/~Y_{1}: Q1196.3 (D), R2.2
/~Y_{2}: Q1198.3 (D), R3.2
/~Y_{3}: Q1200.3 (D), R4.2
/~Y_{4}: Q1202.3 (D), R5.2
/~Y_{5}: Q1204.3 (D), R6.2
/~Y_{6}: Q1206.3 (D), R7.2
/~Y_{7}: Q1208.3 (D), R8.2
/~Y_{8}: Q1210.3 (D), R9.2
/~Y_{9}: Q1212.3 (D), R10.2
/~Y_{10}: Q1214.3 (D), R11.2
/~Y_{11}: Q1216.3 (D), R12.2
/~Y_{12}: Q1218.3 (D), R13.2
/~Y_{13}: Q1220.3 (D), R14.2
/~Y_{14}: Q1222.3 (D), R15.2
/~Y_{15}: Q1224.3 (D), R16.2
GND: C1.2, C2.2, C3.2, C4.2, Q1194.2 (S), Q1196.2 (S), Q1198.2 (S), Q1200.2 (S), Q1202.2 (S), Q1204.2 (S), Q1206.2 (S), Q1208.2 (S), Q1210.2 (S), Q1212.2 (S), Q1214.2 (S), Q1216.2 (S), Q1218.2 (S), Q1220.2 (S), Q1222.2 (S), Q1224.2 (S)
