tiydwe/SRAM/kicad/smt_to_dip/smt_to_dip.kicad_pcb

## KiCad design kicad/smt_to_dip/smt_to_dip.kicad_pcb (2026-10-17)

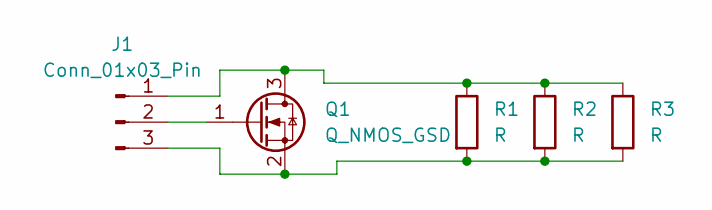
[picture p60: schematic smt_to_dip.kicad_sch]

Parts:
J1: Conn_01x03_Pin; PinHeader_1x03_P2.54mm_Vertical
Q1: Q_NMOS_GSD; SOT-23
R1: R; C_0603_1608Metric_Pad1.08x0.95mm_HandSolder
R2: R; C_0805_2012Metric_Pad1.18x1.45mm_HandSolder
R3: R; C_1206_3216Metric_Pad1.33x1.80mm_HandSolder

Connections:
unnamed: J1.1, Q1.3 (D), R1.1, R2.1, R3.1
unnamed: J1.2, Q1.1 (G)
unnamed: J1.3, Q1.2 (S), R1.2, R2.2, R3.2

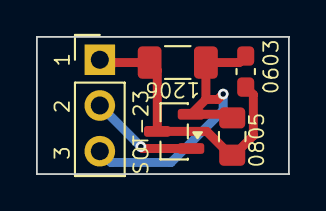
[picture p61: board smt_to_dip.kicad_pcb from above]

Board: 2 copper layers, 14.0 x 7.6 mm, 5 parts (0 on the bottom side), 3 nets.
