tiydwe/SRAM/(commit log)

2026-10-03 Initial ram board schematic
    [1BIT_CELL.kicad_sch, 1_16_5V_DEMUX_NOTOUT.kicad_sch, 5VNOT.kicad_sch, 5V_5NAND.kicad_sch, 8BIT_ROW.kicad_sch, LOGIC_TO_WL_LEVEL_SHIFT.kicad_sch, sramBoard.kicad_pcb, sramBoard.kicad_sch]
2026-10-03 initial refolder
    [1BIT_CELL.kicad_sch, 1_16_5V_DEMUX_NOTOUT.kicad_sch, 5VNOT.kicad_sch, 5V_5NAND.kicad_sch, 8BIT_ROW.kicad_sch, LOGIC_TO_WL_LEVEL_SHIFT.kicad_sch, sramBoard.kicad_sch]
2026-10-03 create project files
    [5VNOT.kicad_sch]
2026-10-04 first pcb deign for main boards
    [1BIT_CELL.kicad_pcb, 1BIT_CELL.kicad_sch, 1_16_5V_DEMUX_NOTOUT.kicad_pcb, 1_16_5V_DEMUX_NOTOUT.kicad_sch, 5VNOT.kicad_pcb, 5VNOT.kicad_sch, 5V_5NAND.kicad_pcb, 5V_5NAND.kicad_sch]
2026-10-04 improve pcb labeling
    [sramBoard.kicad_pcb]
2026-10-05 added busbars but still some issues
    [8BIT_ROW.kicad_pcb, mainDemuxBoard.kicad_pcb, mainDemuxBoard.kicad_sch, sramBoard.kicad_pcb]
2026-10-05 did more simulation work
    [BIT_LINE_BOOST.kicad_pcb, BIT_LINE_BOOST.kicad_sch, sramBoard.kicad_pcb]
2026-10-06 add pmos resistors
    [1BIT_CELL.kicad_pcb, 1BIT_CELL.kicad_sch, 8BIT_ROW.kicad_pcb, LOGIC_TO_WL_LEVEL_SHIFT.kicad_sch, sramBoard.kicad_pcb]
2026-10-07 finish main pcb
    [1BIT_CELL.kicad_pcb, 1BIT_CELL.kicad_sch, 5VNOT.kicad_sch, 5V_5NAND.kicad_sch, 8BIT_ROW.kicad_pcb, LOGIC_TO_WL_LEVEL_SHIFT.kicad_sch, bom.csv, designators.csv]
2026-10-07 finish schematic for main demux board
    [16_NOT.kicad_pcb, 16_NOT.kicad_sch, 1_16_5V_DEMUX_NOTOUT.kicad_pcb, 1_16_5V_DEMUX_NOTOUT.kicad_sch, 5VNOT.kicad_pcb, 5VNOT.kicad_sch, 5V_5NAND.kicad_pcb, 5V_5NAND.kicad_sch]
2026-10-08 finish main demux board
    [5VNOT.kicad_sch, bom.csv, designators.csv, mainDemuxBoard.kicad_pcb, positions.csv]
2026-10-08 begin main controller board
    [1TO2_DEMUX.kicad_pcb, 1TO2_DEMUX.kicad_sch, 8_1TO2_DEMUX.kicad_pcb, 8_1TO2_DEMUX.kicad_sch, controllerBoard.kicad_pcb, controllerBoard.kicad_sch, dlatch.kicad_pcb, dlatch.kicad_sch]
2026-10-09 finish address to bit line decoder
    [1TO2_DEMUX.kicad_sch, 8NOT.kicad_pcb, 8NOT.kicad_sch, 8_1TO2_DEMUX.kicad_sch, controllerBoard.kicad_sch]
2026-10-10 Finish input stage schematic
    [1TO2_DEMUX.kicad_sch, 8DLATCH.kicad_sch, 8_BL_CTRLR.kicad_pcb, 8_BL_CTRLR.kicad_sch, RISING_EDGE_DETECTOR.kicad_pcb, RISING_EDGE_DETECTOR.kicad_sch, SCHMITT_TRIGGER.kicad_pcb, SCHMITT_TRIGGER.kicad_sch]
2026-10-11 finish main schematic
2026-10-12 change to charge pump
2026-10-15 did more simulation, added bom
2026-10-16 fix main ram board
2026-10-17 created smt to dip board
2026-10-17 update main board schematic
2026-10-18 routed charge pump
2026-10-18 continue routing main controller board
2026-10-18 finished routing all sub schematics
2026-10-21 add mounting holes
2026-10-24 Add breakout board through holes on main ram board
2026-10-25 create schematic for input board and footprints
2026-10-26 finish main input board
2026-10-28 update bom, add more capacitors
